tommy2002t/LITHIUM_BOARD/LITHIUM_Board_Design_Calculations.xlsx

Sheet: Summary
LITHIUM Board Design Calculations
IC | Design item | Selected schematic values | Result | Meaning
BQ25750 | FB divider / battery regulation | RTOP=249 kΩ, RBOT=34.8 kΩ, VFB=1.536 V, RFBG=33 Ω | VBAT ≈ 12.54 V | Battery regulation voltage for the 3S pack.
BQ25750 | ACUV / ACOV divider | RAC1=1 MΩ, RAC2=100 kΩ, RAC3=20 kΩ | ACUV≈10.27 V, ACOV≈67.20 V | Input valid/overvoltage thresholds.
BQ25750 | Hardware charge current limit | RICHG=34.8 kΩ, KICHG=50 A·kΩ | ICHG≈1.44 A | Maximum charge current set by the ICHG pin.
BQ25750 | Hardware input current limit | RILIM=10 kΩ, KILIM=50 A·kΩ | ILIM≈5.00 A | Maximum input current set by ILIM_HIZ.
BQ76942 | Internal balancing current | RIN=100 Ω, RCB=25 Ω typ, VCELL=4.2 V | IBAL≈18.7 mA | Approximate internal cell balancing current.
BQ25750 Calculations
Variable / Step | Symbol | Value | Unit | Excel formula
1. FB bottom resistor / battery regulation voltage
Top FB resistor | RTOP | 249000.0000 | Ω
Feedback reference voltage | VFB | 1.5360 | V
Target battery regulation voltage | VBATREG_target | 12.6000 | V
FBG internal/reference resistance | RFBG | 33.0000 | Ω
Datasheet formula |  |  |  | RBOT = RTOP × VFB / (VBATREG − VFB) + RFBG
Ideal RBOT calculation | RBOT_ideal | 34601.33 | Ω | 249000 × 1,536 / (12,6 − 1,536) + 33
Selected RBOT | RBOT_selected | 34800.0000 | Ω
Actual VBAT formula |  |  |  | VBAT = VFB × (1 + RTOP / (RBOT_selected − RFBG))
Actual battery regulation voltage | VBAT_actual | 12.5368 | V | 1,536 × (1 + 249000 / (34800 − 33))
Meaning |  |  |  |  | The battery pack will regulate near 12.54 V
2. ACUV / ACOV divider thresholds
RAC1 | RAC1 | 1000.0000 | kΩ
RAC2 | RAC2 | 100.0000 | kΩ
RAC3 | RAC3 | 20.0000 | kΩ | 10 kΩ + 10 kΩ
ACUV reference | VACUV_REF | 1.1000 | V
ACOV reference | VACOV_REF | 1.2000 | V
Sum of divider resistors | RSUM | 1120.0000 | kΩ | RAC1 + RAC2 + RAC3
Lower divider sum | RLOW | 120.0000 | kΩ | RAC2 + RAC3
Datasheet ACUV formula |  |  |  | VACUV = 1.1 × (RAC1 + RAC2 + RAC3) / (RAC2 + RAC3)
ACUV threshold | VACUV | 10.27 | V | 1,1 × 1120 / 120
Datasheet ACOV formula |  |  |  | VACOV = 1.2 × (RAC1 + RAC2 + RAC3) / RAC3
ACOV threshold | VACOV | 67.20 | V | 1,2 × 1120 / 20
Meaning |  |  |  |  | Upper Voltage: 67.2V Lower Voltage: 10.27V
3. ICHG resistor / hardware charge current limit
KICHG typical | KICHG | 50.0000 | A·kΩ
Selected ICHG resistor | RICHG | 34.8000 | kΩ
Datasheet formula |  |  |  | ICHG_MAX = KICHG / RICHG
Charge current limit | ICHG_MAX | 1.4368 | A | 50 / 34,8
Meaning |  |  |  |  | The charger hardware limit is about 1.44 A.
4. ILIM_HIZ resistor / hardware input current limit
KILIM typical | KILIM | 50.0000 | A·kΩ
Selected ILIM_HIZ resistor | RILIM | 10.0000 | kΩ
RAC_SNS | RAC_SNS | 2.0000 | mΩ
Datasheet formula |  |  |  | ILIM = KILIM / RILIM
Input current limit | ILIM | 5.00 | A | 50 / 10
Meaning |  |  |  |  | The hardware input limit is about 5 A.
BQ76942 Calculations
Variable / Step | Symbol | Value | Unit | Excel formula
2. Internal cell balancing current
Cell input resistor | RIN | 100.0000 | Ω
Internal balancing resistance typical | RCB | 25.0000 | Ω
Maximum cell voltage | VCELL_MAX | 4.2000 | V
Nominal cell voltage | VCELL_NOM | 3.7000 | V
Formula |  |  |  | IBAL = VCELL / (2 × RIN + RCB)
Balancing current at 4.2 V | IBAL_MAX |  | A
Balancing current at 3.7 V | IBAL_NOM |  | A
Meaning |  | 0.01867 |  | 4,2 / (2 × 100 + 25) | Internal Balancing: 16–19 mA
 |  | 0.01644 |  | 3,7 / (2 × 100 + 25)

Sheet: BQ25750_Calcs
BQ25750 Calculations
Variable / Step | Symbol | Value | Unit | Excel formula / manual calculation
1. FB bottom resistor / battery regulation voltage
Top FB resistor | RTOP | 249000.0000 | Ω
Feedback reference voltage | VFB | 1.5360 | V
Target battery regulation voltage | VBATREG_target | 12.6000 | V
FBG internal/reference resistance | RFBG | 33.0000 | Ω
Datasheet formula |  |  |  | RBOT = RTOP × VFB / (VBATREG − VFB) + RFBG
Ideal RBOT calculation | RBOT_ideal | 34601.33 | Ω | 249000 × 1,536 / (12,6 − 1,536) + 33
Selected RBOT | RBOT_selected | 34800.0000 | Ω
Actual VBAT formula |  |  |  | VBAT = VFB × (1 + RTOP / (RBOT_selected − RFBG))
Actual battery regulation voltage | VBAT_actual | 12.5368 | V | 1,536 × (1 + 249000 / (34800 − 33))
Meaning |  |  |  |  | The battery pack will regulate near 12.54 V, slightly below 12.60 V.
2. ACUV / ACOV divider thresholds
RAC1 | RAC1 | 1000.0000 | kΩ
RAC2 | RAC2 | 100.0000 | kΩ
RAC3 | RAC3 | 20.0000 | kΩ | 10 kΩ + 10 kΩ
ACUV reference | VACUV_REF | 1.1000 | V
ACOV reference | VACOV_REF | 1.2000 | V
Sum of divider resistors | RSUM | 1120.0000 | kΩ | RAC1 + RAC2 + RAC3
Lower divider sum | RLOW | 120.0000 | kΩ | RAC2 + RAC3
Datasheet ACUV formula |  |  |  | VACUV = 1.1 × (RAC1 + RAC2 + RAC3) / (RAC2 + RAC3)
ACUV threshold | VACUV | 10.27 | V | 1,1 × 1120 / 120
Datasheet ACOV formula |  |  |  | VACOV = 1.2 × (RAC1 + RAC2 + RAC3) / RAC3
ACOV threshold | VACOV | 67.20 | V | 1,2 × 1120 / 20
Meaning |  |  |  |  | Upper Voltage: 67.2V Lower Voltage: 10.27V
3. ICHG resistor / hardware charge current limit
KICHG typical | KICHG | 50.0000 | A·kΩ
Selected ICHG resistor | RICHG | 34.8000 | kΩ
Datasheet formula |  |  |  | ICHG_MAX = KICHG / RICHG
Charge current limit | ICHG_MAX | 1.4368 | A | 50 / 34,8
Meaning |  |  |  |  | The charger hardware limit is about 1.44 A.
4. ILIM_HIZ resistor / hardware input current limit
KILIM typical | KILIM | 50.0000 | A·kΩ
Selected ILIM_HIZ resistor | RILIM | 10.0000 | kΩ
RAC_SNS | RAC_SNS | 2.0000 | mΩ
Datasheet formula |  |  |  | ILIM = KILIM / RILIM
Input current limit | ILIM | 5.00 | A | 50 / 10
Meaning |  |  |  |  | The hardware input limit is about 5 A.

Sheet: BQ76942_Calcs
BQ76942 Calculations
Variable / Step | Symbol | Value | Unit | Excel formula / manual calculation
2. Internal cell balancing current
Cell input resistor | RIN | 100.0000 | Ω
Internal balancing resistance typical | RCB | 25.0000 | Ω
Maximum cell voltage | VCELL_MAX | 4.2000 | V
Nominal cell voltage | VCELL_NOM | 3.7000 | V
Formula |  |  |  | IBAL = VCELL / (2 × RIN + RCB)
Balancing current at 4.2 V | IBAL_MAX |  | A
Balancing current at 3.7 V | IBAL_NOM |  | A
Meaning |  | 0.01867 |  | 4,2 / (2 × 100 + 25) | Internal Balancing: 16–19 mA
 |  | 0.01644 |  | 3,7 / (2 × 100 + 25)
