tommy2002t/LITHIUM_BOARD/Lithium_Board.step

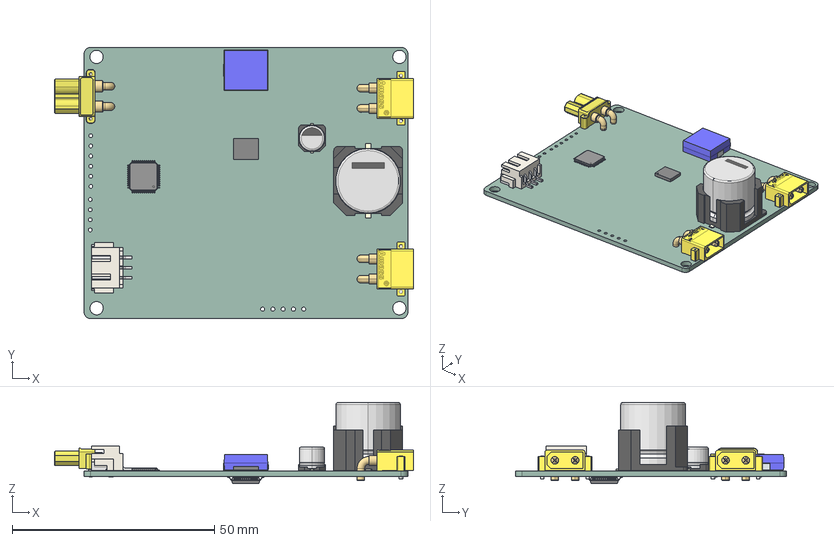
[picture p1: CAD file, 2026-06-28]
Lithium_Board.step
88.7 x 67.0 x 20.0 mm
WSIZE CODE D-001
WSIZE CODE D-002
WSIZE CODE D-003 x 2
BODY_VBC48A
LEAD_VBC48A x 48
FilletPin1
FilletPin2
XT30PW-F
XT30PW-M x 2
BQ25750RRVR
S3B-XH-SM4-TB_LF__SN_
SIZE CODE J16-001
SIZE CODE J16-002
SIZE CODE J16-003 x 2
SIZE CODE J16-004 x 2
PinsArrayLR
PinsArrayTB
Lithium_Board_PCB
