tommy2002t/LITHIUM_BOARD/Lithium_Footprints/LIB_1N4148WQ-7-F/1N4148WQ-7-F/3D/1N4148WQ-7-F.stp

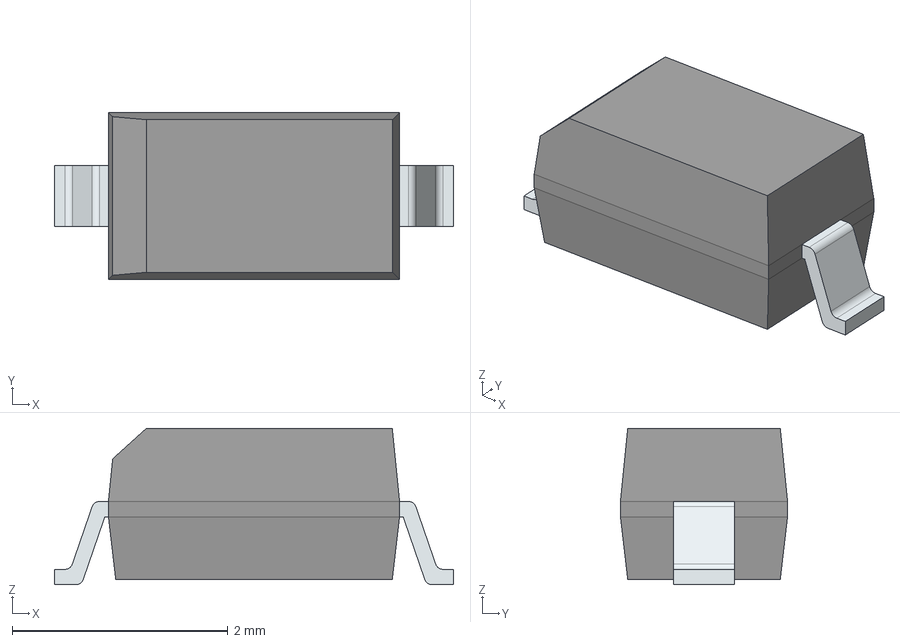
[picture p2: CAD file, 2026-05-30]
Lithium_Footprints/LIB_1N4148WQ-7-F/1N4148WQ-7-F/3D/1N4148WQ-7-F.stp
3.70 x 1.55 x 1.45 mm
FilletPinL
FilletPinR
