tommy2002t/LITHIUM_BOARD/Lithium_Footprints/LIB_ACT45B-101-2P-TL003/ACT45B-101-2P-TL003/3D/ACT45B-101-2P-TL003.stp

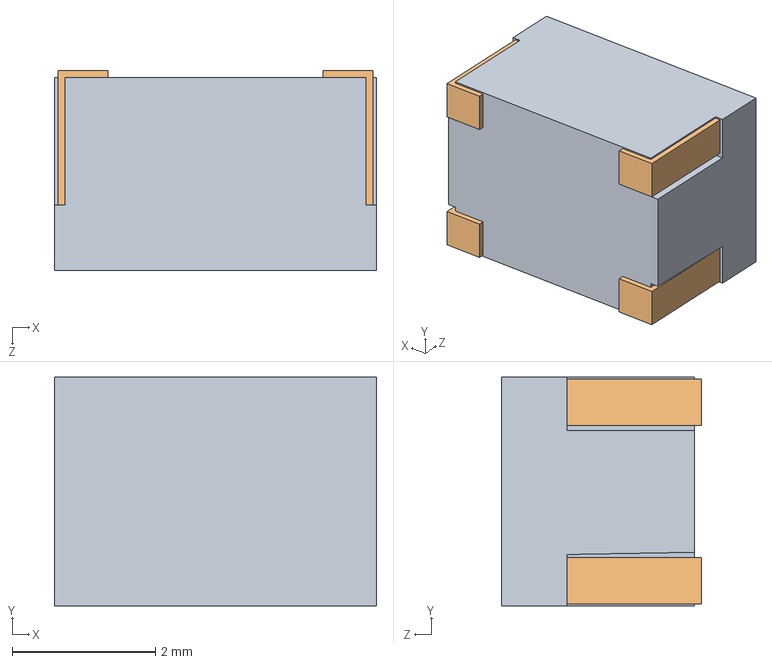
[picture p3: CAD file, 2026-06-06]
Lithium_Footprints/LIB_ACT45B-101-2P-TL003/ACT45B-101-2P-TL003/3D/ACT45B-101-2P-TL003.stp
4.50 x 3.20 x 2.80 mm
ACT45B DRコアブロック(typ size)
ACT45B 端子ブロック(typ size) x 4
