tommy2002t/LITHIUM_BOARD/Lithium_Footprints/LIB_C0603C101J5GACTU/C0603C101J5GACTU/3D/C0603C101J5GACTU.stp

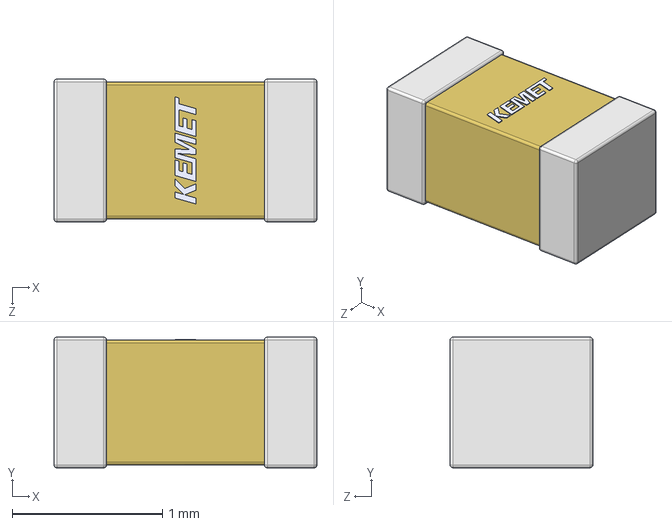
[picture p4: CAD file, 2026-05-30]
Lithium_Footprints/LIB_C0603C101J5GACTU/C0603C101J5GACTU/3D/C0603C101J5GACTU.stp
1.75 x 0.87 x 0.95 mm
