tommy2002t/LITHIUM_BOARD/Lithium_Footprints/LIB_C0603C104K1RACAUTO/C0603C104K1RACAUTO/3D/C0603C104K1RACAUTO.stp

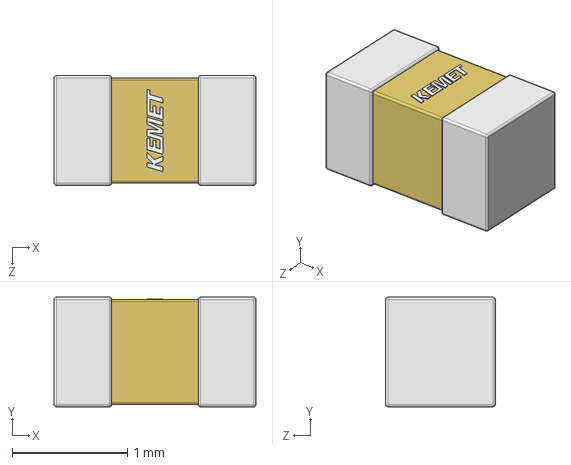
[picture p5: CAD file, 2026-05-30]
Lithium_Footprints/LIB_C0603C104K1RACAUTO/C0603C104K1RACAUTO/3D/C0603C104K1RACAUTO.stp
1.75 x 0.95 x 0.95 mm
