tommy2002t/LITHIUM_BOARD/Lithium_Footprints/LIB_C0603C122K5RACTU/C0603C122K5RACTU/3D/C0603C122K5RACTU.stp

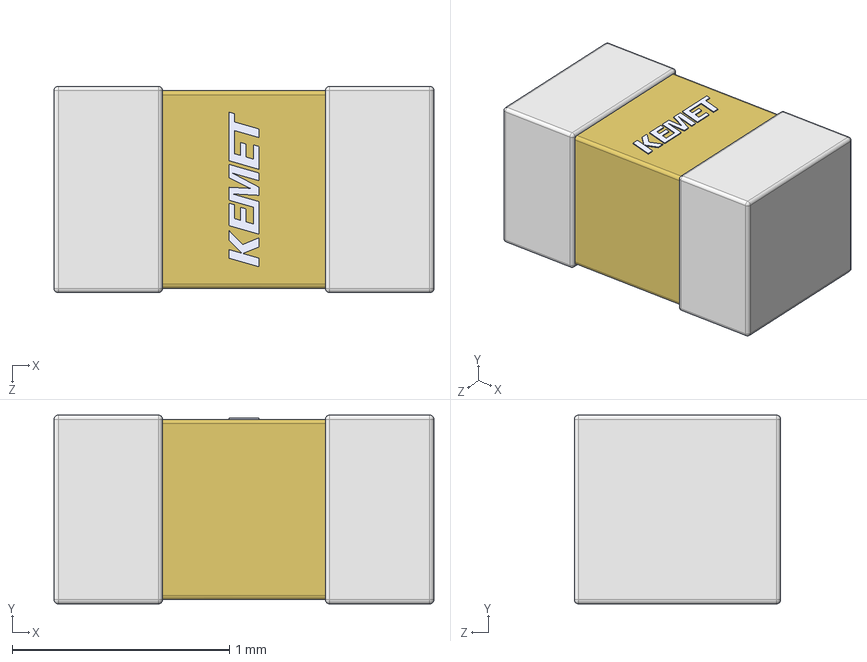
[picture p6: CAD file, 2026-05-30]
Lithium_Footprints/LIB_C0603C122K5RACTU/C0603C122K5RACTU/3D/C0603C122K5RACTU.stp
1.75 x 0.87 x 0.95 mm
