tommy2002t/LITHIUM_BOARD/Lithium_Footprints/LIB_C0805C224K5RACTU/C0805C224K5RACTU/3D/C0805C224K5RACTU.stp

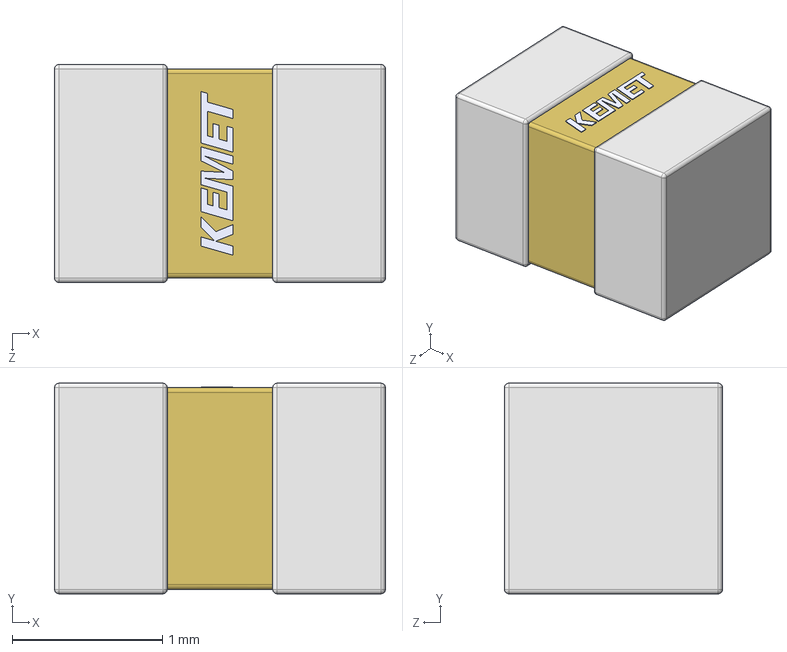
[picture p7: CAD file, 2026-05-30]
Lithium_Footprints/LIB_C0805C224K5RACTU/C0805C224K5RACTU/3D/C0805C224K5RACTU.stp
2.20 x 1.40 x 1.45 mm
