tommy2002t/LITHIUM_BOARD/Lithium_Footprints/LIB_C0805X474K5RECAUTO/C0805X474K5RECAUTO/3D/C0805X474K5RECAUTO.stp

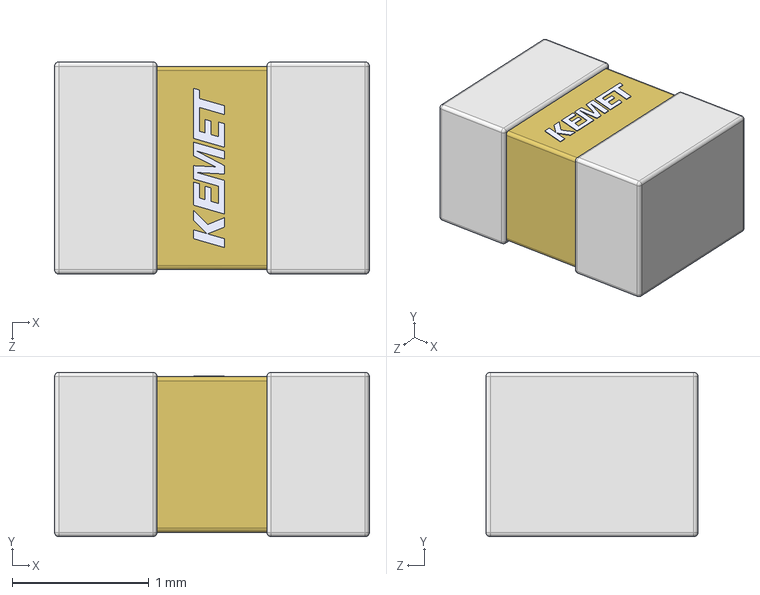
[picture p8: CAD file, 2026-05-30]
Lithium_Footprints/LIB_C0805X474K5RECAUTO/C0805X474K5RECAUTO/3D/C0805X474K5RECAUTO.stp
2.30 x 1.20 x 1.55 mm
