tommy2002t/LITHIUM_BOARD/Lithium_Footprints/LIB_C1206C225K5RACTU/C1206C225K5RACTU/3D/C1206C225K5RACTU.stp

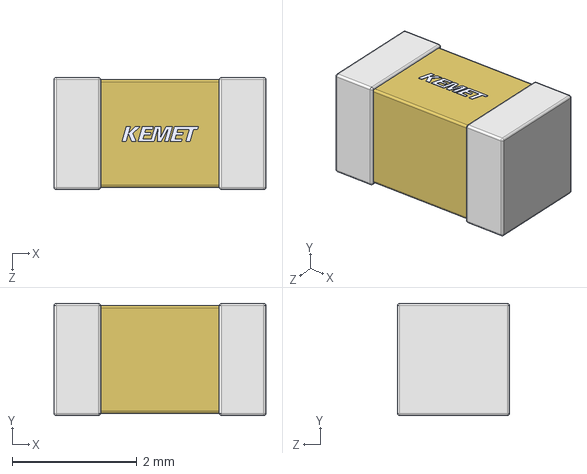
[picture p9: CAD file, 2026-05-30]
Lithium_Footprints/LIB_C1206C225K5RACTU/C1206C225K5RACTU/3D/C1206C225K5RACTU.stp
3.40 x 1.80 x 1.80 mm
