tommy2002t/LITHIUM_BOARD/Lithium_Footprints/LIB_C1210C154K5RACTU/C1210C154K5RACTU/3D/C1210C154K5RACTU.stp

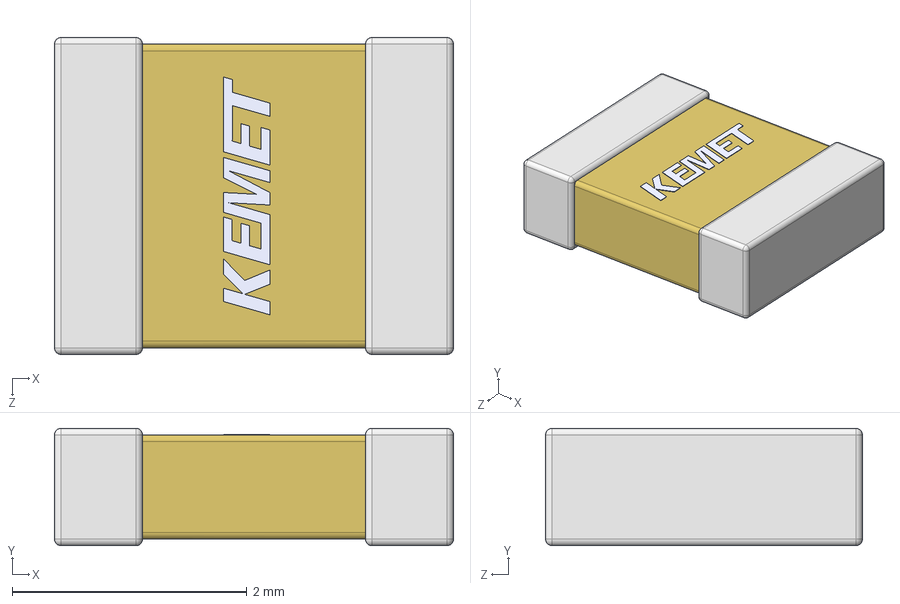
[picture p10: CAD file, 2026-05-30]
Lithium_Footprints/LIB_C1210C154K5RACTU/C1210C154K5RACTU/3D/C1210C154K5RACTU.stp
3.40 x 1.00 x 2.70 mm
