tommy2002t/LITHIUM_BOARD/Lithium_Footprints/LIB_C2012X7R1H105K125AB/C2012X7R1H105K125AB/3D/C2012X7R1H105K125AB.stp

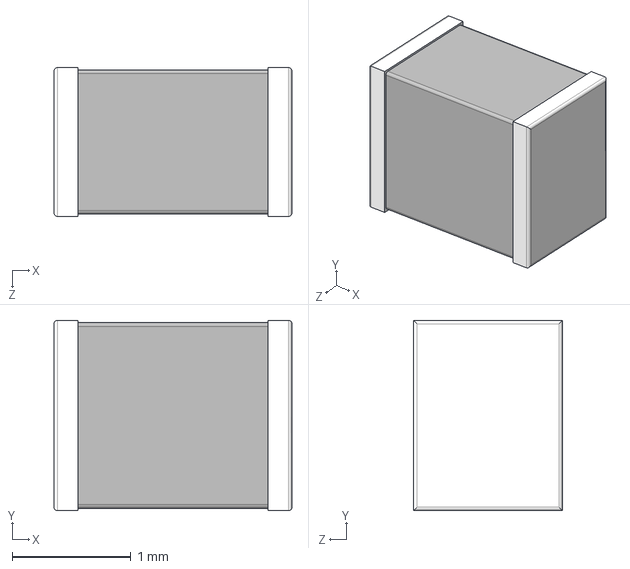
[picture p11: CAD file, 2026-05-30]
Lithium_Footprints/LIB_C2012X7R1H105K125AB/C2012X7R1H105K125AB/3D/C2012X7R1H105K125AB.stp
2.00 x 1.60 x 1.25 mm
