tommy2002t/LITHIUM_BOARD/Lithium_Footprints/LIB_CC0603KRX7R9BB104/CC0603KRX7R9BB104/3D/CC0603KRX7R9BB104.stp

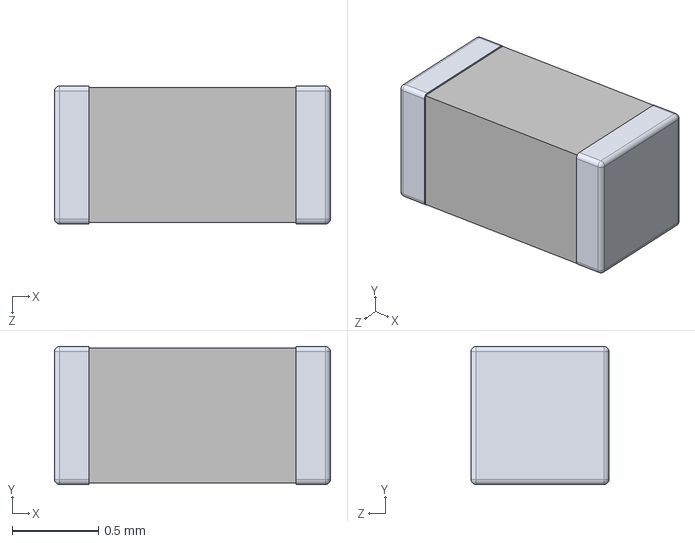
[picture p12: CAD file, 2026-05-30]
Lithium_Footprints/LIB_CC0603KRX7R9BB104/CC0603KRX7R9BB104/3D/CC0603KRX7R9BB104.stp
1.60 x 0.8 x 0.8 mm
