tommy2002t/LITHIUM_BOARD/Lithium_Footprints/LIB_CDBMT2100-HF/CDBMT2100-HF/3D/CDBMT2100-HF.stp

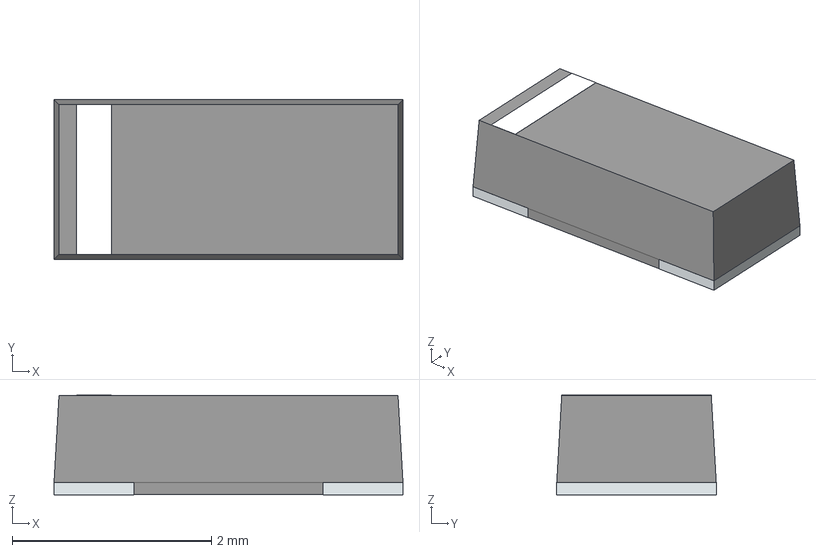
[picture p13: CAD file, 2026-06-14]
Lithium_Footprints/LIB_CDBMT2100-HF/CDBMT2100-HF/3D/CDBMT2100-HF.stp
3.50 x 1.60 x 1.00 mm
PinKIdent
PinK
PinA
