tommy2002t/LITHIUM_BOARD/Lithium_Footprints/LIB_CDSOT23-T24CAN/CDSOT23-T24CAN/3D/CDSOT23-T24CAN.stp

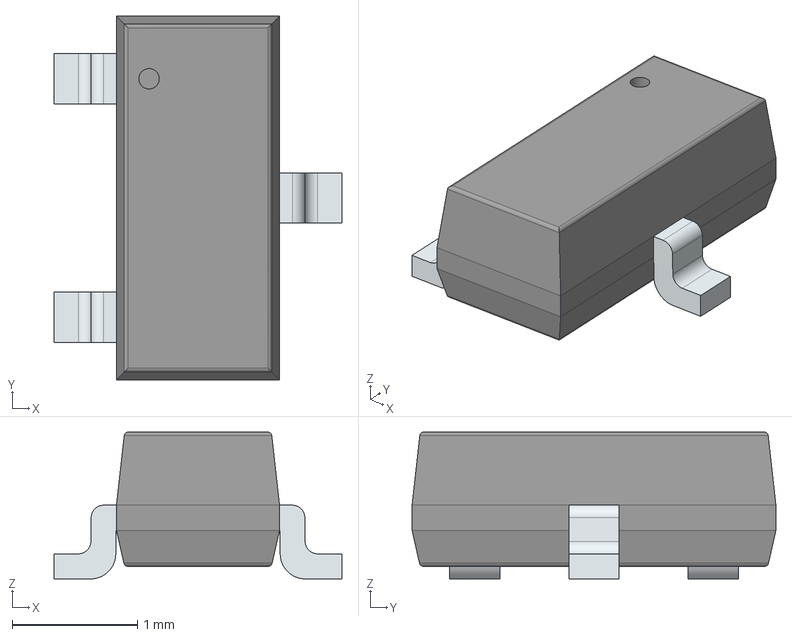
[picture p14: CAD file, 2026-06-06]
Lithium_Footprints/LIB_CDSOT23-T24CAN/CDSOT23-T24CAN/3D/CDSOT23-T24CAN.stp
2.29 x 2.90 x 1.17 mm
PinsArrayL
FilletPinR
