tommy2002t/LITHIUM_BOARD/Lithium_Footprints/LIB_CGA5L2X7R2A474K160AA/CGA5L2X7R2A474K160AA/3D/CGA5L2X7R2A474K160AA.stp

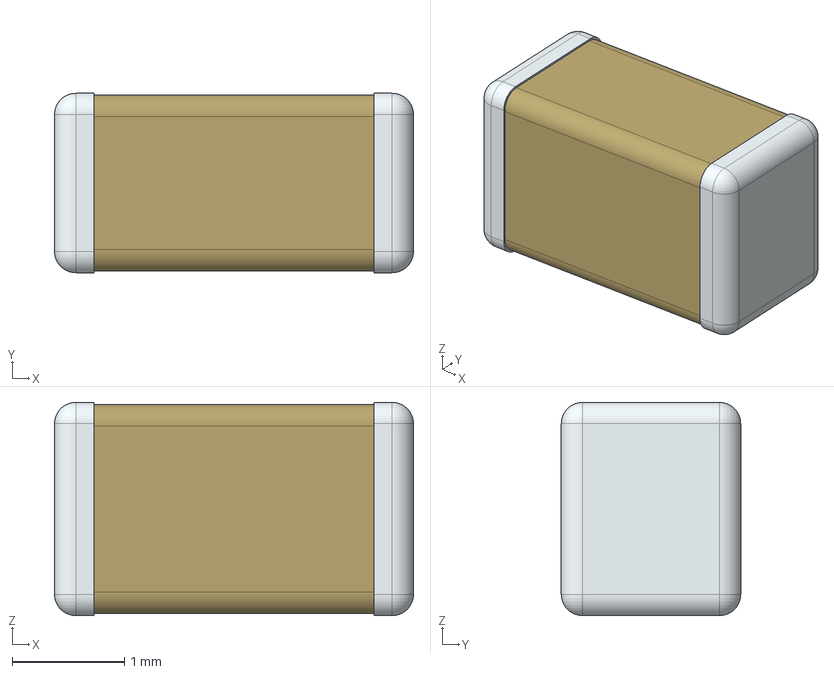
[picture p15: CAD file, 2026-05-30]
Lithium_Footprints/LIB_CGA5L2X7R2A474K160AA/CGA5L2X7R2A474K160AA/3D/CGA5L2X7R2A474K160AA.stp
3.20 x 1.60 x 1.90 mm
