tommy2002t/LITHIUM_BOARD/Lithium_Footprints/LIB_CL31B225KCHSNNE/CL31B225KCHSNNE/3D/CL31B225KCHSNNE.stp

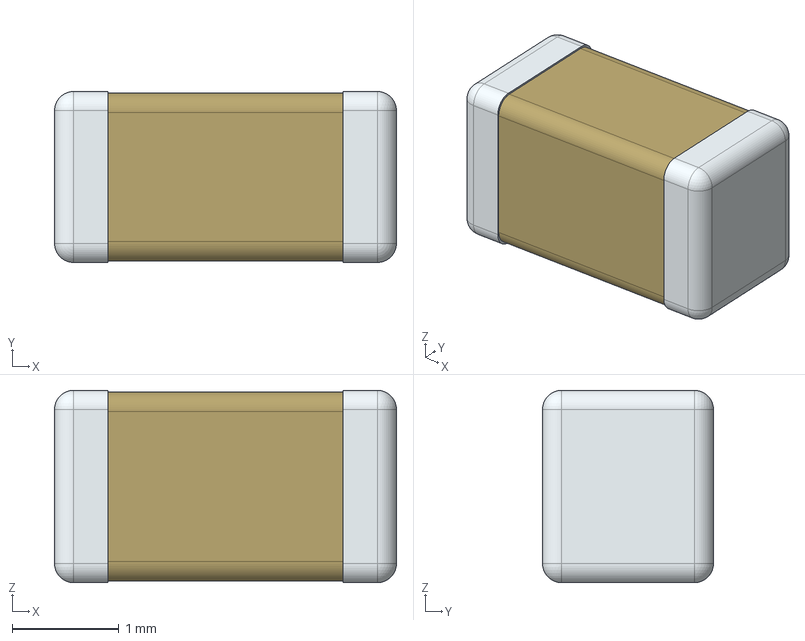
[picture p16: CAD file, 2026-05-30]
Lithium_Footprints/LIB_CL31B225KCHSNNE/CL31B225KCHSNNE/3D/CL31B225KCHSNNE.stp
3.20 x 1.60 x 1.80 mm
