tommy2002t/LITHIUM_BOARD/Lithium_Footprints/LIB_CL32B106KBVVPLE/CL32B106KBVVPLE/3D/CL32B106KBVVPLE.stp

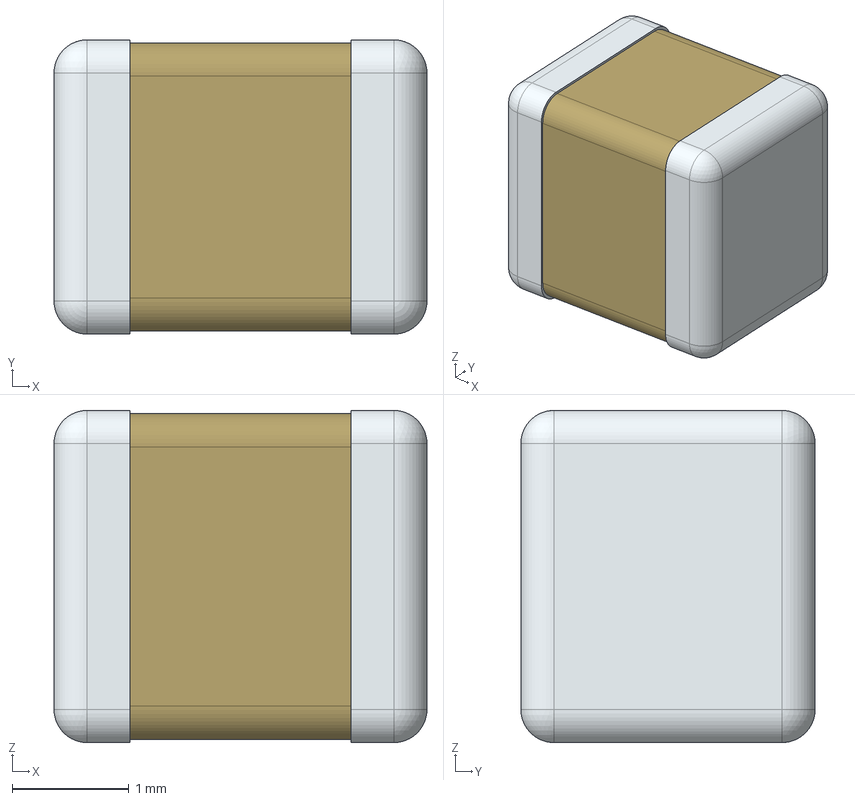
[picture p17: CAD file, 2026-05-30]
Lithium_Footprints/LIB_CL32B106KBVVPLE/CL32B106KBVVPLE/3D/CL32B106KBVVPLE.stp
3.20 x 2.52 x 2.85 mm
