tommy2002t/LITHIUM_BOARD/Lithium_Footprints/LIB_EEE-TP1K391V/EEE-TP1K391V/3D/EEE-TP1K391V.stp

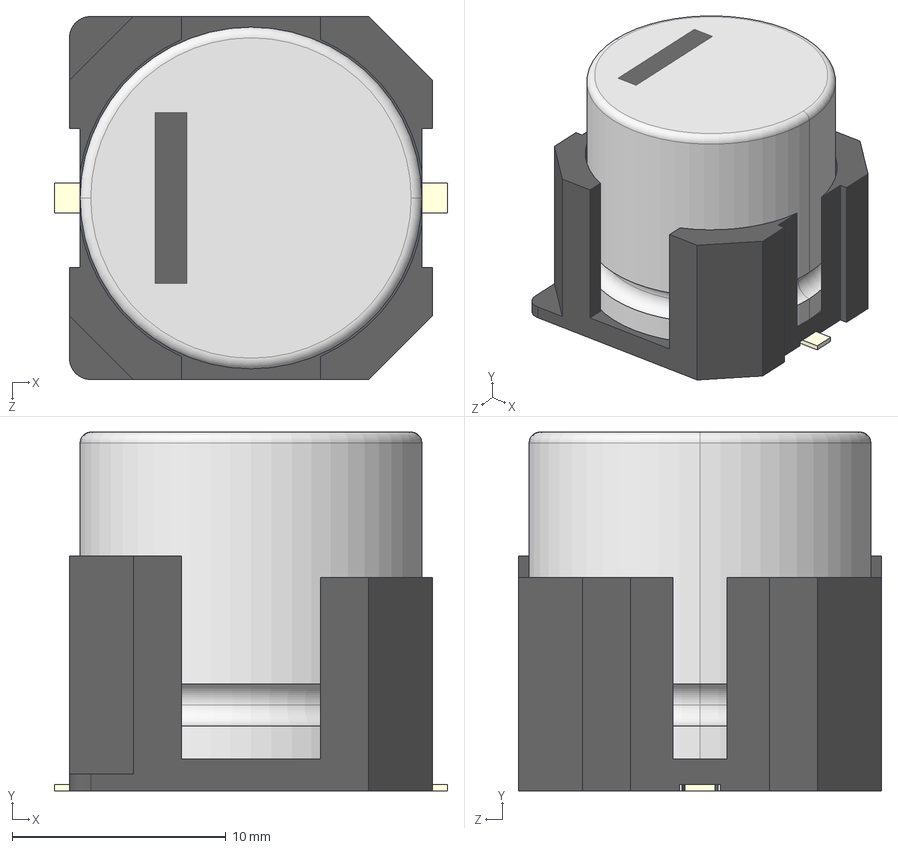
[picture p18: CAD file, 2026-05-30]
Lithium_Footprints/LIB_EEE-TP1K391V/EEE-TP1K391V/3D/EEE-TP1K391V.stp
18.4 x 16.8 x 17.0 mm
SIZE CODE J16-001
SIZE CODE J16-002
SIZE CODE J16-003 x 2
SIZE CODE J16-004 x 2
