tommy2002t/LITHIUM_BOARD/Lithium_Footprints/LIB_EEH-ZL1E151P/EEH-ZL1E151P/3D/EEH-ZL1E151P.stp

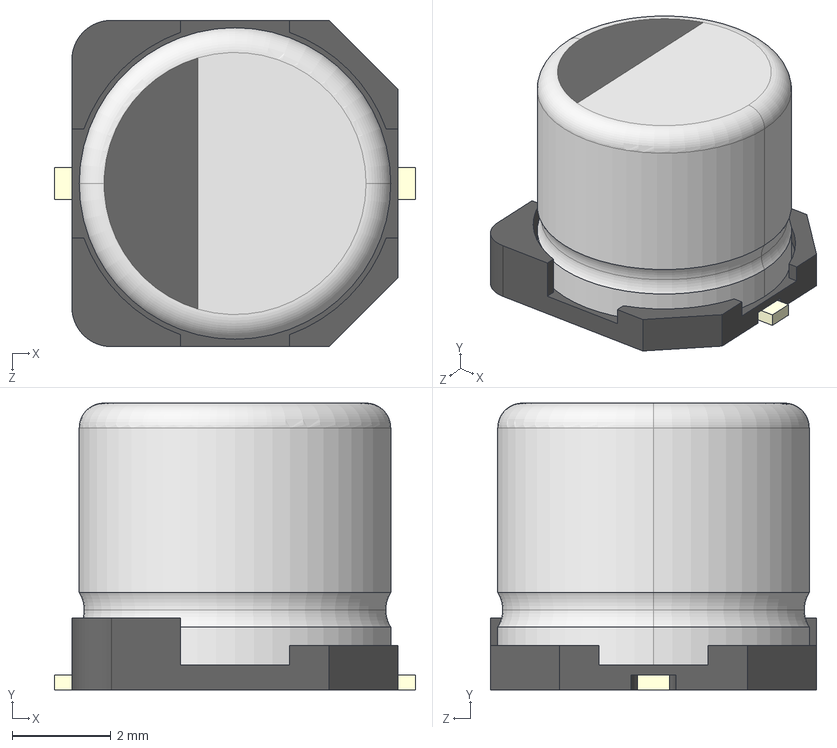
[picture p19: CAD file, 2026-05-30]
Lithium_Footprints/LIB_EEH-ZL1E151P/EEH-ZL1E151P/3D/EEH-ZL1E151P.stp
7.30 x 5.80 x 6.60 mm
標準SIZE CODE D-001
標準SIZE CODE D-002
標準SIZE CODE D-003 x 2
