tommy2002t/LITHIUM_BOARD/Lithium_Footprints/LIB_ERJ-2RKF60R4X/ERJ-2RKF60R4X/3D/ERJ-2RKF60R4X.stp

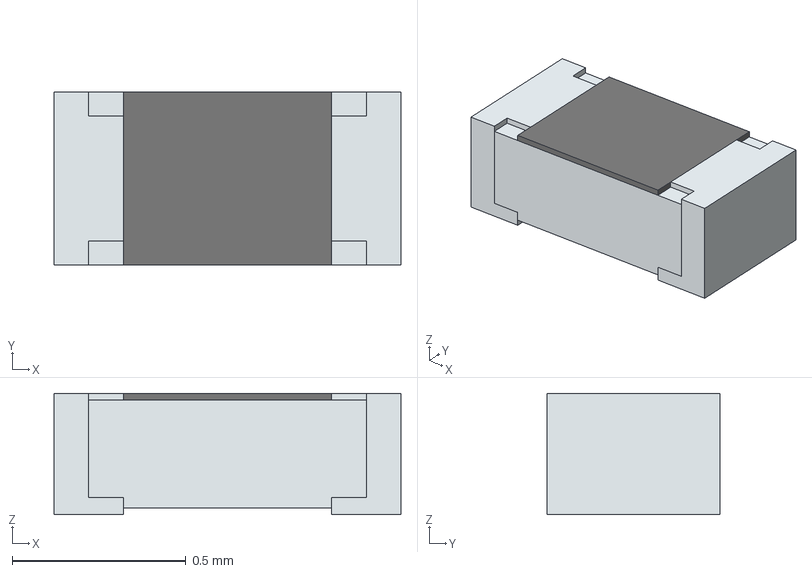
[picture p20: CAD file, 2026-06-06]
Lithium_Footprints/LIB_ERJ-2RKF60R4X/ERJ-2RKF60R4X/3D/ERJ-2RKF60R4X.stp
1.00 x 0.5 x 0.35 mm
solidBody
Terminal
solidTop
