tommy2002t/LITHIUM_BOARD/Lithium_Footprints/LIB_ERJ-3GEY0R00V/ERJ-3GEY0R00V/3D/ERJ-3GEY0R00V.stp

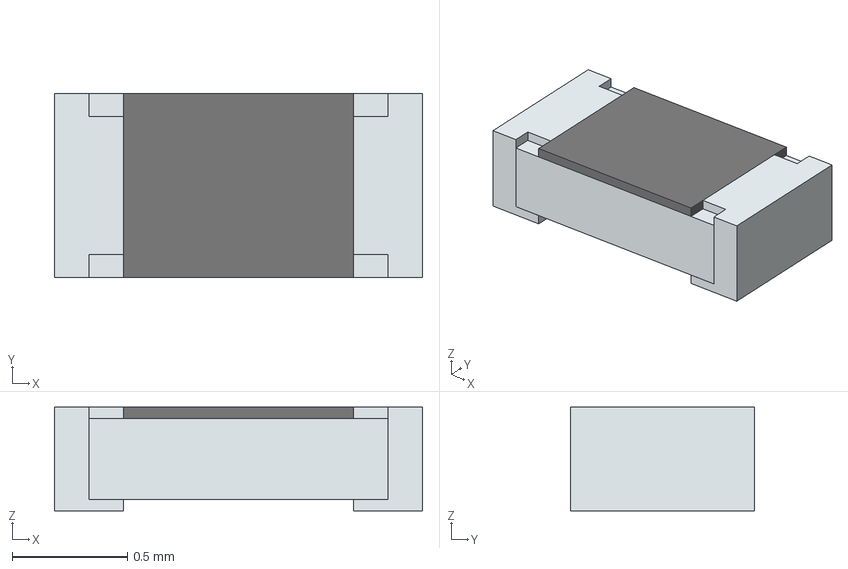
[picture p21: CAD file, 2026-05-30]
Lithium_Footprints/LIB_ERJ-3GEY0R00V/ERJ-3GEY0R00V/3D/ERJ-3GEY0R00V.stp
1.60 x 0.8 x 0.45 mm
solidBody
Terminal
solidTop
