tommy2002t/LITHIUM_BOARD/Lithium_Footprints/LIB_ESDCAN24-2BLY/ESDCAN24-2BLY/3D/ESDCAN24-2BLY.stp

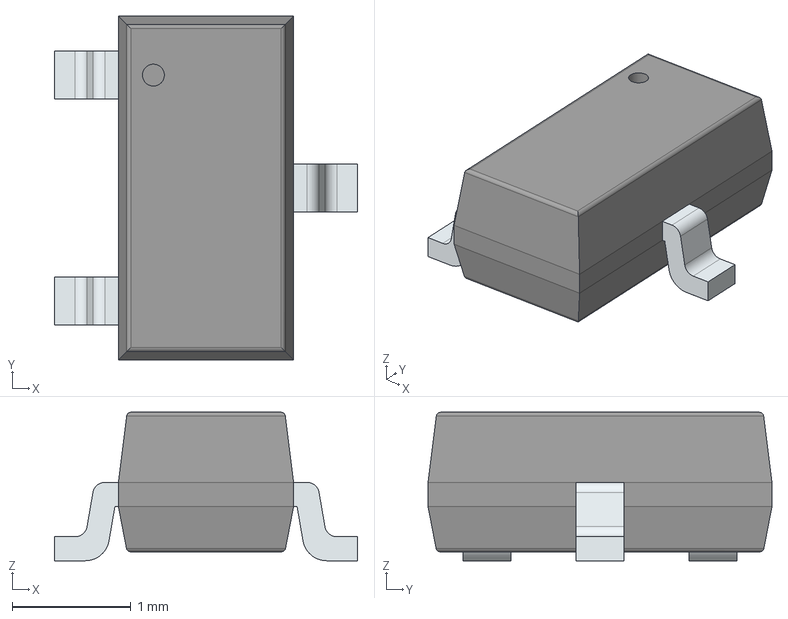
[picture p22: CAD file, 2026-07-23]
Lithium_Footprints/LIB_ESDCAN24-2BLY/ESDCAN24-2BLY/3D/ESDCAN24-2BLY.stp
2.55 x 2.90 x 1.25 mm
PinsArrayL
FilletPinR
