tommy2002t/LITHIUM_BOARD/Lithium_Footprints/LIB_GCM188R71H103KA37J/GCM188R71H103KA37J/3D/GCM188R71H103KA37J.stp

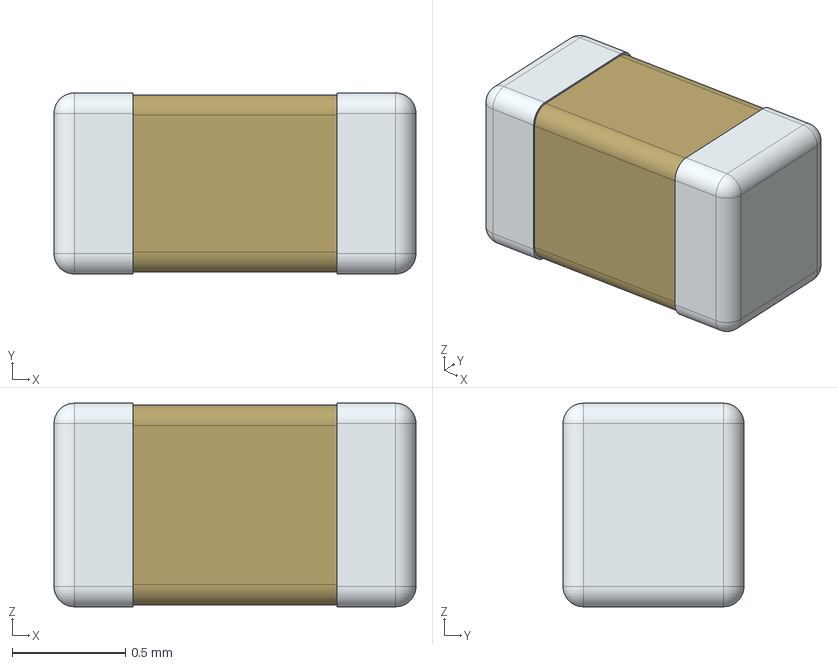
[picture p23: CAD file, 2026-05-30]
Lithium_Footprints/LIB_GCM188R71H103KA37J/GCM188R71H103KA37J/3D/GCM188R71H103KA37J.stp
1.60 x 0.8 x 0.9 mm
