tommy2002t/LITHIUM_BOARD/Lithium_Footprints/LIB_GRM155R71H104KE14J/GRM155R71H104KE14J/3D/GRM155R71H104KE14J.stp

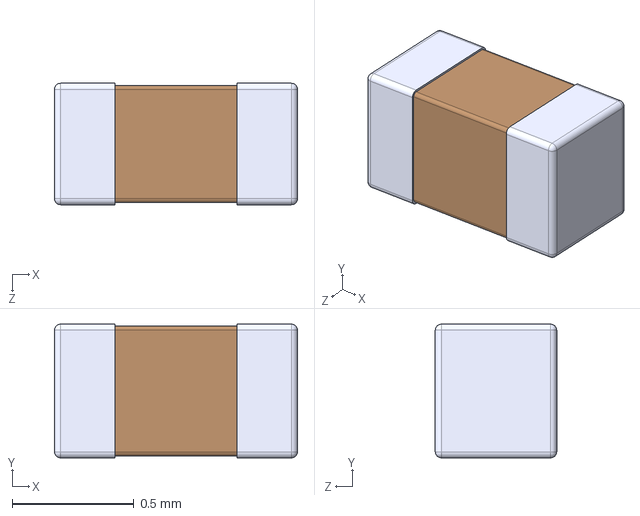
[picture p24: CAD file, 2026-06-06]
Lithium_Footprints/LIB_GRM155R71H104KE14J/GRM155R71H104KE14J/3D/GRM155R71H104KE14J.stp
1.00 x 0.55 x 0.5 mm
