tommy2002t/LITHIUM_BOARD/Lithium_Footprints/LIB_GRM188R72A472KA01D/GRM188R72A472KA01D/3D/GRM188R72A472KA01D.stp

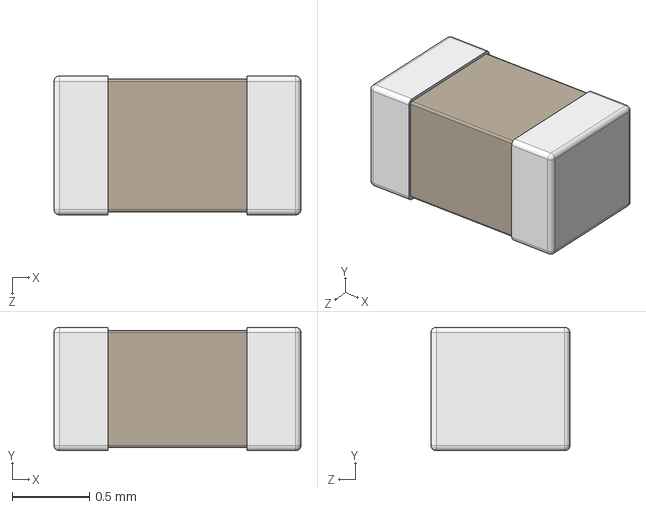
[picture p25: CAD file, 2026-06-06]
Lithium_Footprints/LIB_GRM188R72A472KA01D/GRM188R72A472KA01D/3D/GRM188R72A472KA01D.stp
1.60 x 0.8 x 0.9 mm
