tommy2002t/LITHIUM_BOARD/Lithium_Footprints/LIB_KAM32LR72A475KU/KAM32LR72A475KU/3D/KAM32LR72A475KU.stp

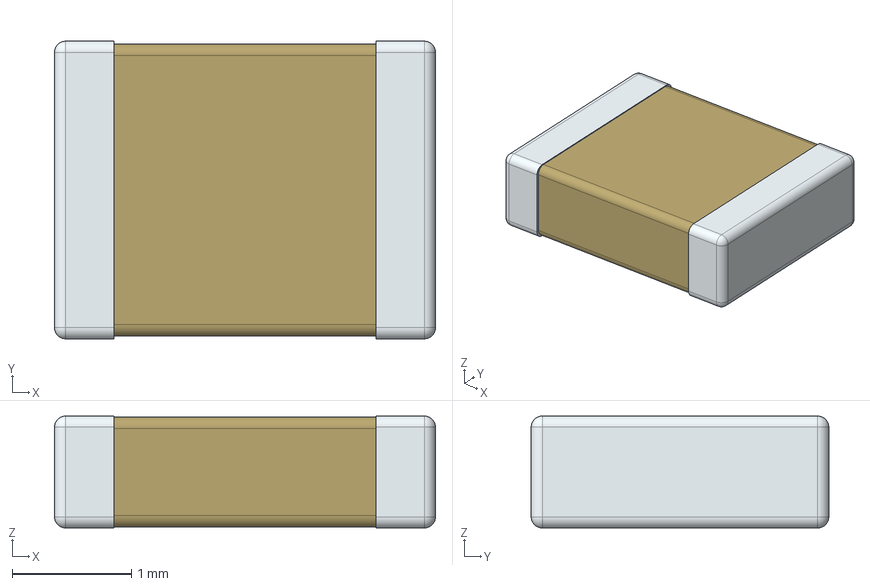
[picture p26: CAD file, 2026-05-30]
Lithium_Footprints/LIB_KAM32LR72A475KU/KAM32LR72A475KU/3D/KAM32LR72A475KU.stp
3.20 x 2.50 x 0.94 mm
