tommy2002t/LITHIUM_BOARD/Lithium_Footprints/LIB_LTST-C190KGKT/LTST-C190KGKT/3D/LTST-C190KGKT.stp

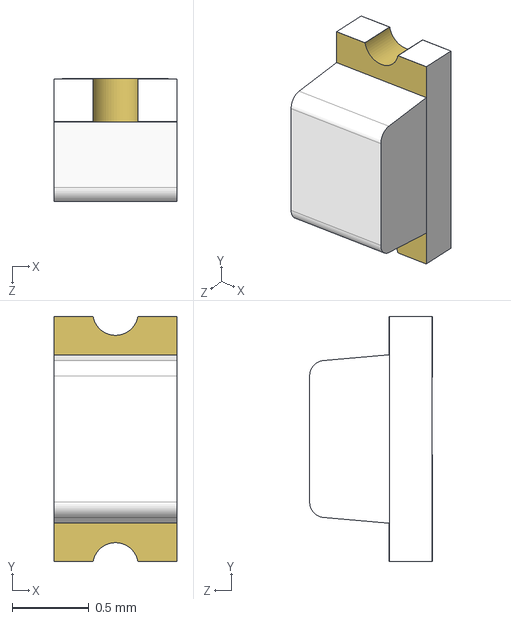
[picture p27: CAD file, 2026-06-06]
Lithium_Footprints/LIB_LTST-C190KGKT/LTST-C190KGKT/3D/LTST-C190KGKT.stp
0.8 x 1.60 x 0.801 mm
