tommy2002t/LITHIUM_BOARD/Lithium_Footprints/LIB_MCP1792T-3302H_DB/MCP1792T-3302H_DB/3D/MCP1792T-3302H_DB.stp

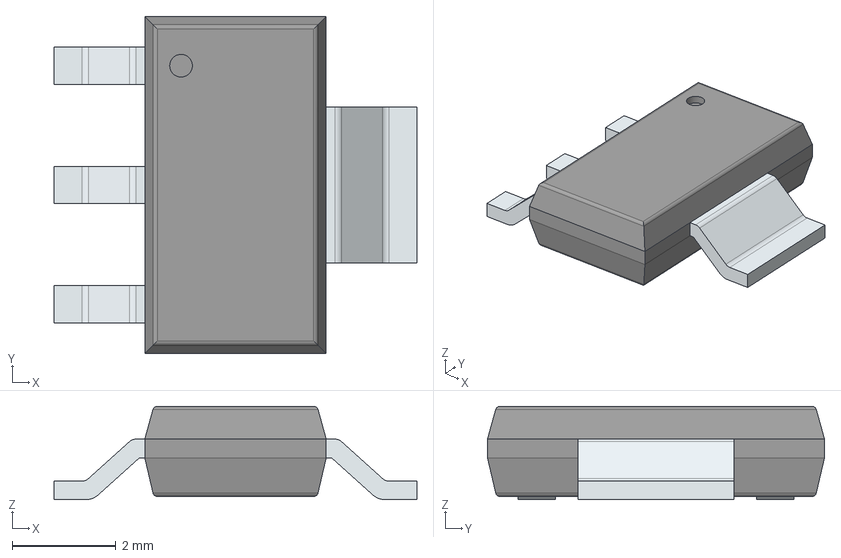
[picture p28: CAD file, 2026-07-16]
Lithium_Footprints/LIB_MCP1792T-3302H_DB/MCP1792T-3302H_DB/3D/MCP1792T-3302H_DB.stp
7.00 x 6.50 x 1.80 mm
PinsArrayL
FilletPinR
