tommy2002t/LITHIUM_BOARD/Lithium_Footprints/LIB_MMBT5551LT1G/MMBT5551LT1G/3D/MMBT5551LT1G.stp

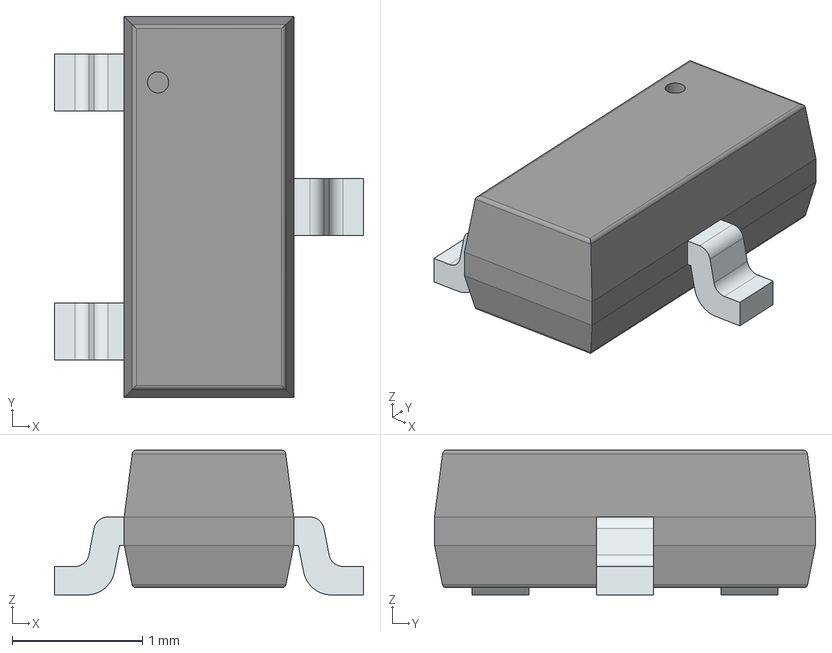
[picture p29: CAD file, 2026-05-30]
Lithium_Footprints/LIB_MMBT5551LT1G/MMBT5551LT1G/3D/MMBT5551LT1G.stp
2.37 x 2.92 x 1.11 mm
PinsArrayL
FilletPinR
