tommy2002t/LITHIUM_BOARD/Lithium_Footprints/LIB_PMR100HZPFU5L00/PMR100HZPFU5L00/3D/PMR100HZPFU5L00.stp

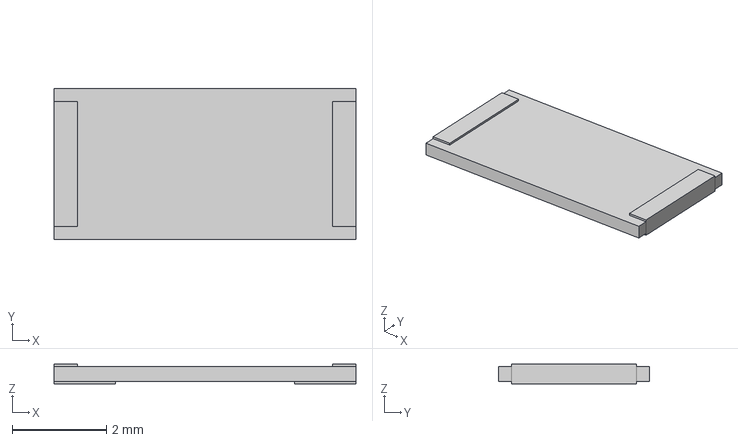
[picture p30: CAD file, 2026-05-30]
Lithium_Footprints/LIB_PMR100HZPFU5L00/PMR100HZPFU5L00/3D/PMR100HZPFU5L00.stp
6.40 x 3.20 x 0.42 mm
