tommy2002t/LITHIUM_BOARD/Lithium_Footprints/LIB_PMR18EZPFV2L00/PMR18EZPFV2L00/3D/PMR18EZPFV2L00.stp

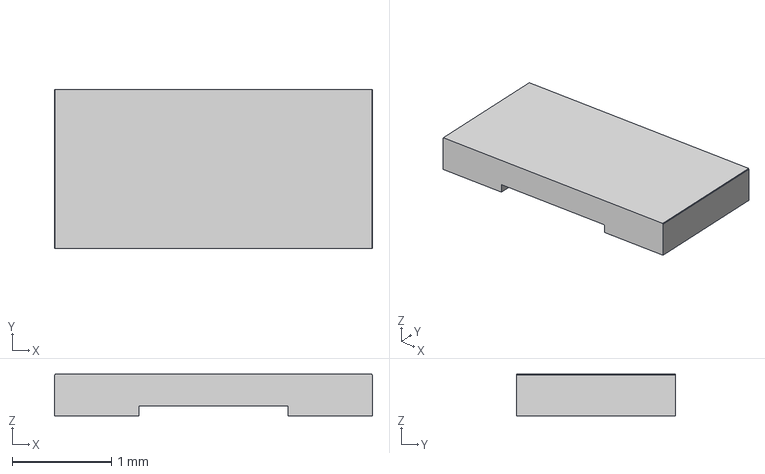
[picture p31: CAD file, 2026-05-30]
Lithium_Footprints/LIB_PMR18EZPFV2L00/PMR18EZPFV2L00/3D/PMR18EZPFV2L00.stp
3.20 x 1.60 x 0.42 mm
