tommy2002t/LITHIUM_BOARD/Lithium_Footprints/LIB_RC0603FR-0710ML/RC0603FR-0710ML/3D/RC0603FR-0710ML.stp

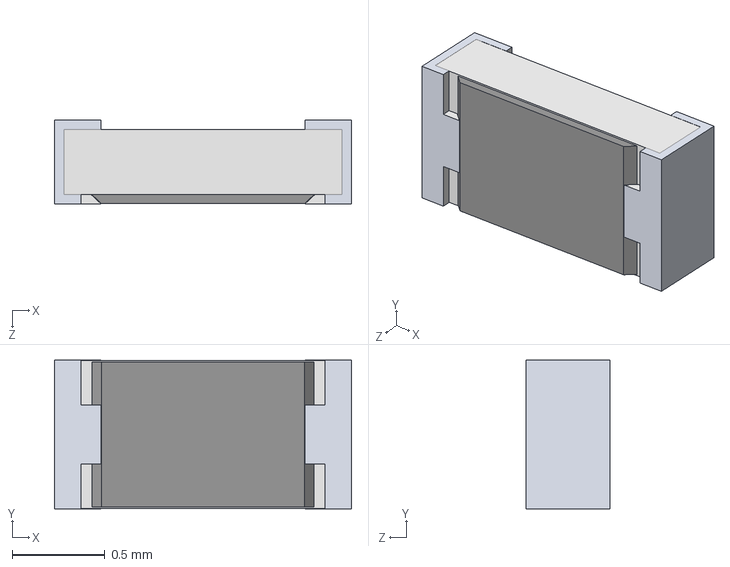
[picture p32: CAD file, 2026-05-30]
Lithium_Footprints/LIB_RC0603FR-0710ML/RC0603FR-0710ML/3D/RC0603FR-0710ML.stp
1.60 x 0.8 x 0.45 mm
