tommy2002t/LITHIUM_BOARD/Lithium_Footprints/LIB_RC0603FR-071KL/RC0603FR-071KL/3D/RC0603FR-071KL.stp

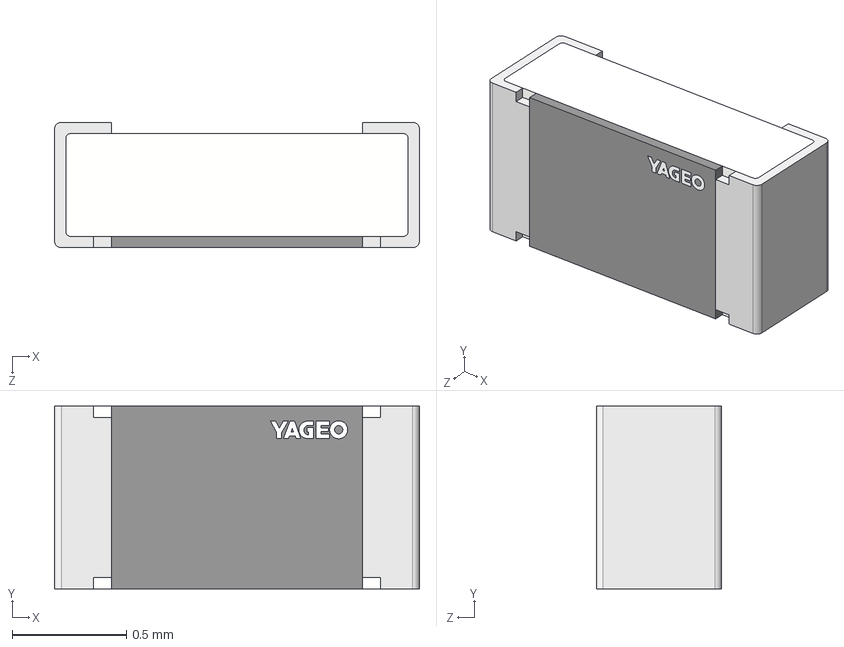
[picture p33: CAD file, 2026-05-30]
Lithium_Footprints/LIB_RC0603FR-071KL/RC0603FR-071KL/3D/RC0603FR-071KL.stp
1.60 x 0.8 x 0.55 mm
Yageo Logo
