tommy2002t/LITHIUM_BOARD/Lithium_Footprints/LIB_RT0603BRD07249KL/RT0603BRD07249KL/3D/RT0603BRD07249KL.stp

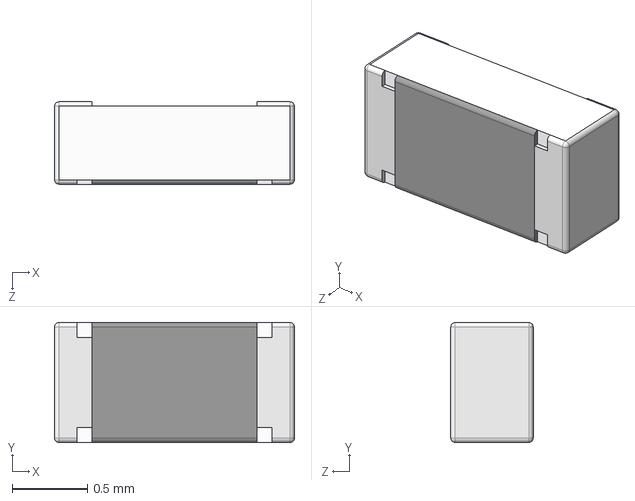
[picture p34: CAD file, 2026-05-30]
Lithium_Footprints/LIB_RT0603BRD07249KL/RT0603BRD07249KL/3D/RT0603BRD07249KL.stp
1.60 x 0.8 x 0.55 mm
