tommy2002t/LITHIUM_BOARD/Lithium_Footprints/LIB_RT0603BRD0735K2L/RT0603BRD0735K2L/3D/RT0603BRD0735K2L.stp

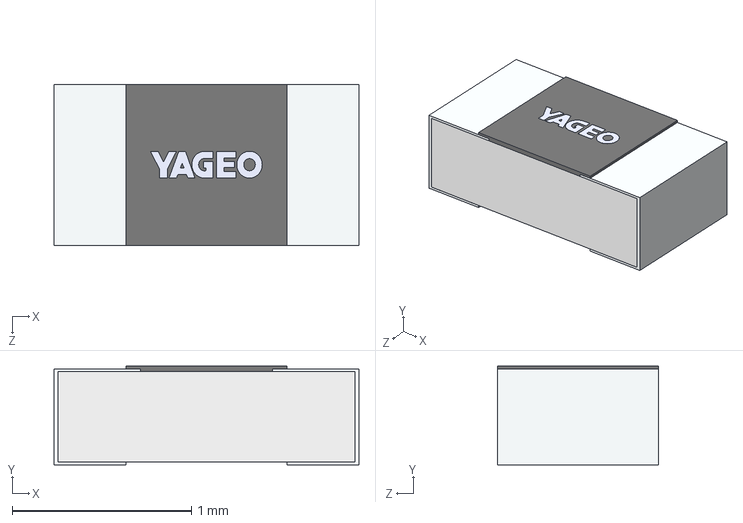
[picture p35: CAD file, 2026-07-15]
Lithium_Footprints/LIB_RT0603BRD0735K2L/RT0603BRD0735K2L/3D/RT0603BRD0735K2L.stp
1.70 x 0.55 x 0.9 mm
