tommy2002t/LITHIUM_BOARD/Lithium_Footprints/LIB_S3B-XH-SM4-TB_LF__SN_/S3B-XH-SM4-TB_LF__SN_/3D/S3B-XH-SM4-TB_LF__SN_.stp

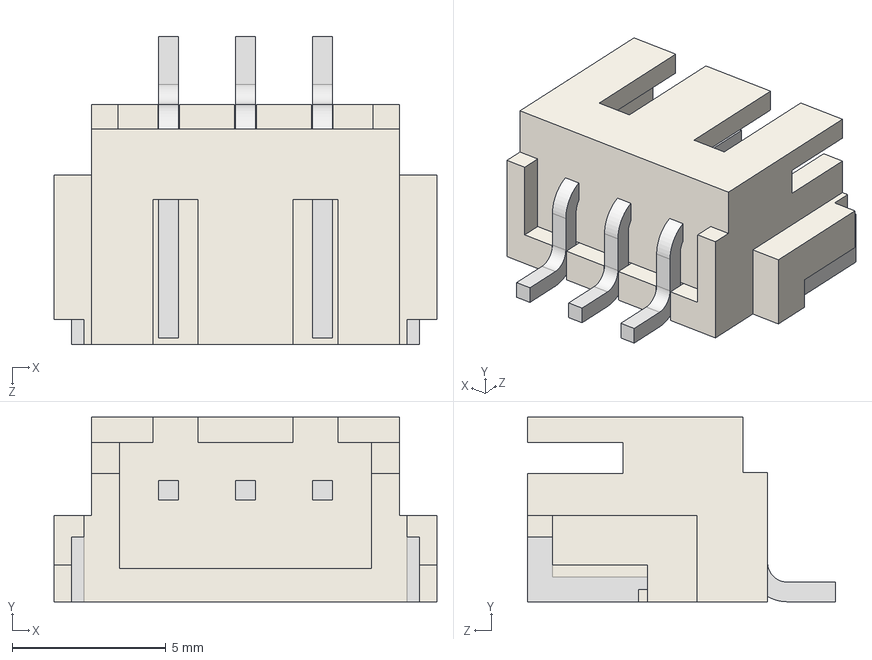
[picture p36: CAD file, 2026-06-06]
Lithium_Footprints/LIB_S3B-XH-SM4-TB_LF__SN_/S3B-XH-SM4-TB_LF__SN_/3D/S3B-XH-SM4-TB_LF__SN_.stp
12.5 x 6.00 x 10.0 mm
