tommy2002t/LITHIUM_BOARD/Lithium_Footprints/LIB_SIR870ADP-T1-GE3/SIR870ADP-T1-GE3/3D/POWERPAK_SO-8_SINGLE_VIS.step

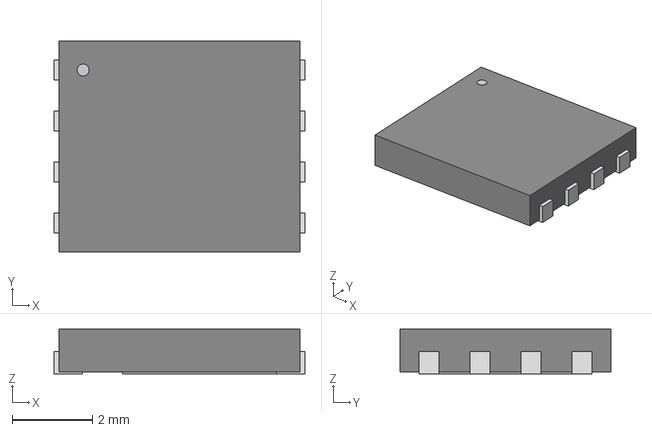
[picture p37: CAD file, 2026-07-05]
Lithium_Footprints/LIB_SIR870ADP-T1-GE3/SIR870ADP-T1-GE3/3D/POWERPAK_SO-8_SINGLE_VIS.step
6.25 x 5.26 x 1.12 mm
