tommy2002t/LITHIUM_BOARD/Lithium_Footprints/LIB_SRP1038A-100M/SRP1038A-100M/3D/SRP1038A-100M.stp

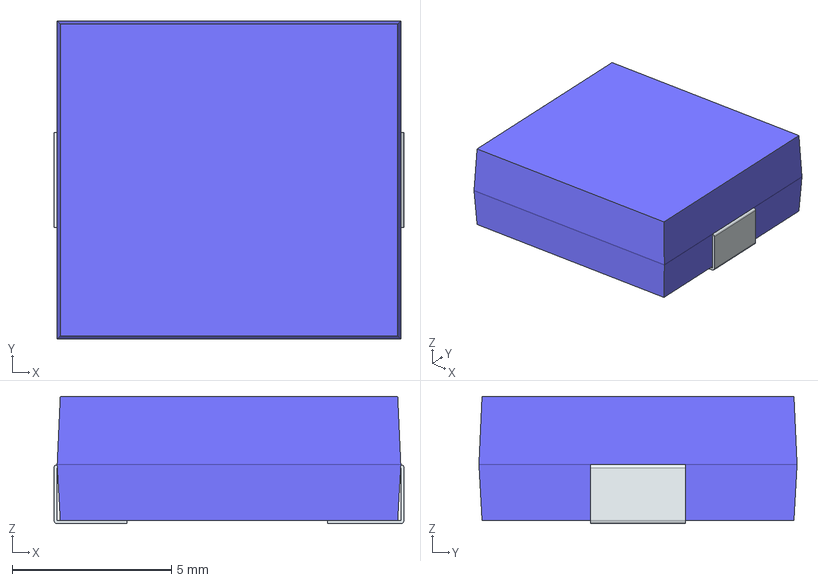
[picture p38: CAD file, 2026-05-30]
Lithium_Footprints/LIB_SRP1038A-100M/SRP1038A-100M/3D/SRP1038A-100M.stp
11.0 x 10.0 x 4.00 mm
FilletPin1
FilletPin2
