tommy2002t/LITHIUM_BOARD/Lithium_Footprints/LIB_STM32G030K6T6/STM32G030K6T6/3D/STM32G030K6T6.stp

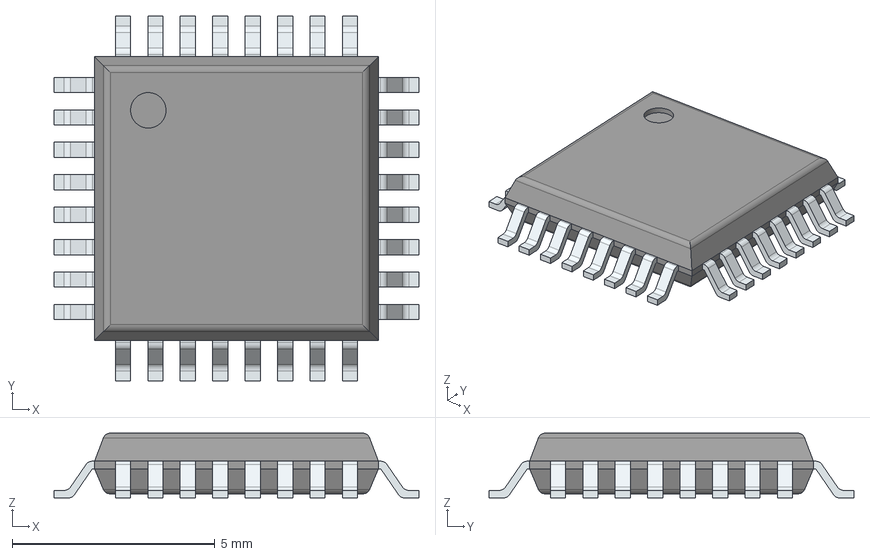
[picture p39: CAD file, 2026-05-30]
Lithium_Footprints/LIB_STM32G030K6T6/STM32G030K6T6/3D/STM32G030K6T6.stp
9.00 x 9.00 x 1.60 mm
PinsArrayLR
PinsArrayTB
