tommy2002t/LITHIUM_BOARD/Lithium_Footprints/LIB_STM32G0B1CBT6N/STM32G0B1CBT6N/3D/STM32G0B1CBT6N.stp

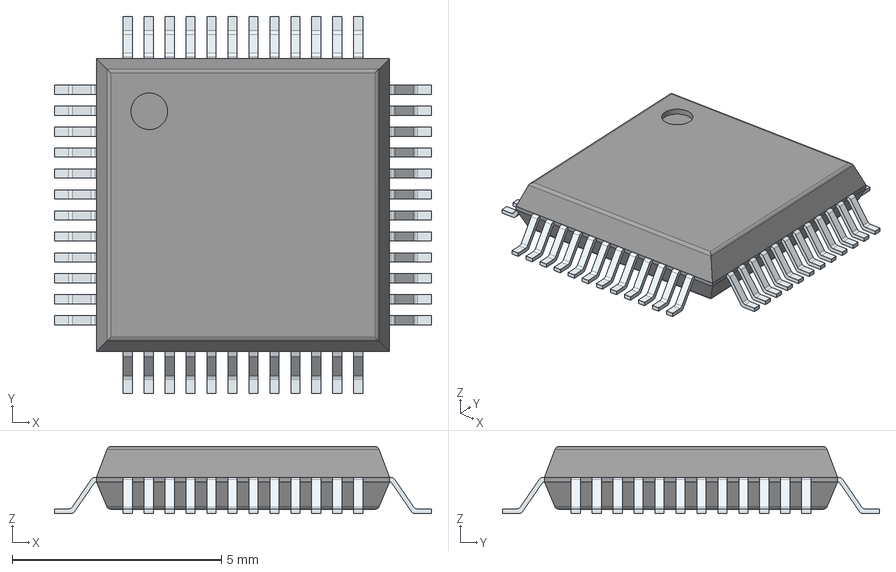
[picture p40: CAD file, 2026-06-06]
Lithium_Footprints/LIB_STM32G0B1CBT6N/STM32G0B1CBT6N/3D/STM32G0B1CBT6N.stp
9.00 x 9.00 x 1.60 mm
PinsArrayLR
PinsArrayTB
