tommy2002t/LITHIUM_BOARD/Lithium_Footprints/LIB_TCAN1044AEVDRQ1/TCAN1044AEVDRQ1/3D/TCAN1044AEVDRQ1.stp

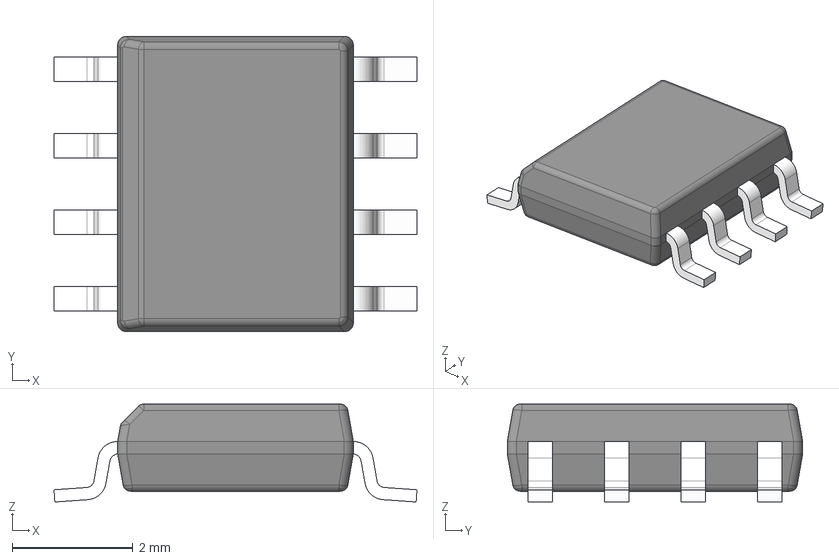
[picture p41: CAD file, 2026-06-06]
Lithium_Footprints/LIB_TCAN1044AEVDRQ1/TCAN1044AEVDRQ1/3D/TCAN1044AEVDRQ1.stp
6.02 x 4.90 x 1.63 mm
BODY-SO
LEAD-D0008A x 8
