tommy2002t/LITHIUM_BOARD/Lithium_Footprints/LIB_TCAN3414DDFR/TCAN3414DDFR/3D/TCAN3414DDFR.stp

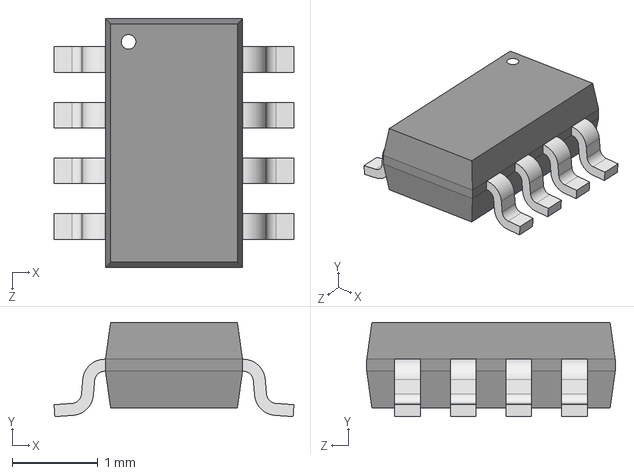
[picture p42: CAD file, 2026-07-23]
Lithium_Footprints/LIB_TCAN3414DDFR/TCAN3414DDFR/3D/TCAN3414DDFR.stp
2.80 x 1.10 x 2.90 mm
