tommy2002t/LITHIUM_BOARD/Lithium_Footprints/LIB_TSW-105-07-G-S/TSW-105-07-G-S/3D/TSW-105-07-G-S.stp

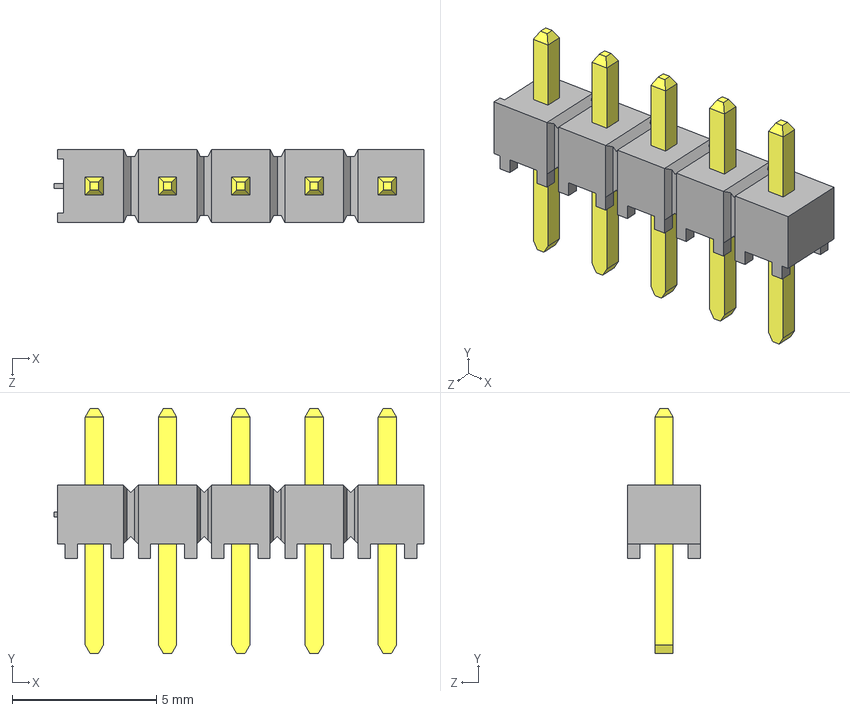
[picture p43: CAD file, 2026-05-30]
Lithium_Footprints/LIB_TSW-105-07-G-S/TSW-105-07-G-S/3D/TSW-105-07-G-S.stp
12.8 x 8.51 x 2.54 mm
T-1S6-21-TSW-1-05-5-S
TSW-105-05-G-S_body
