tommy2002t/LITHIUM_BOARD/Lithium_Footprints/LIB_UMJ325AB7475KMHP/UMJ325AB7475KMHP/3D/UMJ325AB7475KMHP.stp

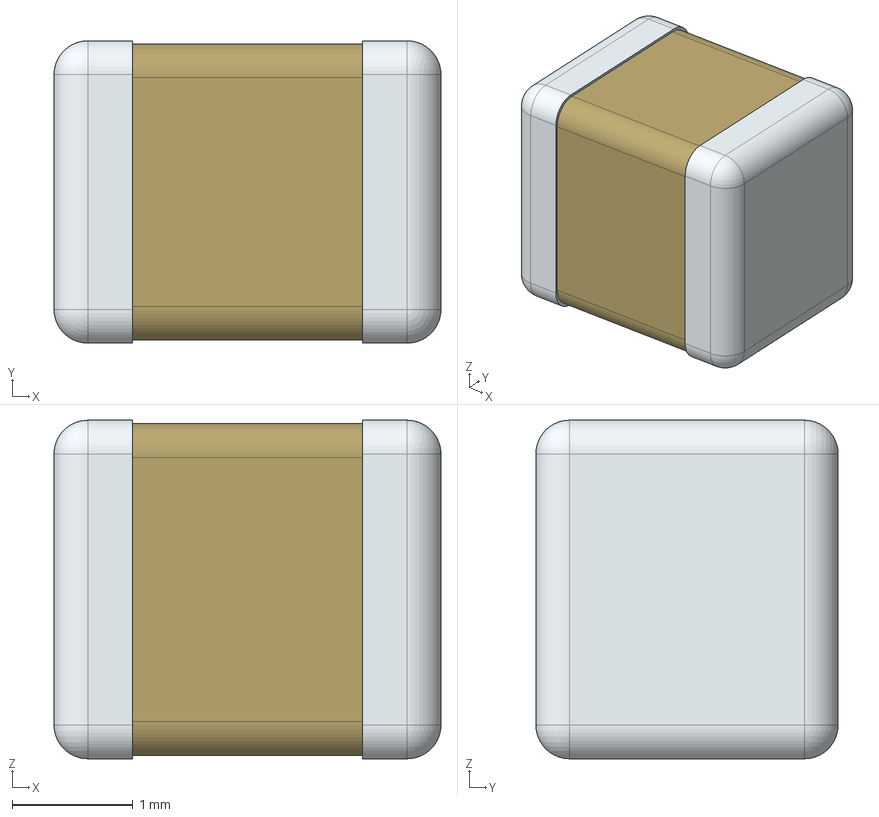
[picture p44: CAD file, 2026-05-30]
Lithium_Footprints/LIB_UMJ325AB7475KMHP/UMJ325AB7475KMHP/3D/UMJ325AB7475KMHP.stp
3.20 x 2.50 x 2.80 mm
