tommy2002t/LITHIUM_BOARD/Lithium_Footprints/LIB_VT1206BRD071ML/VT1206BRD071ML/3D/VT1206BRD071ML.stp

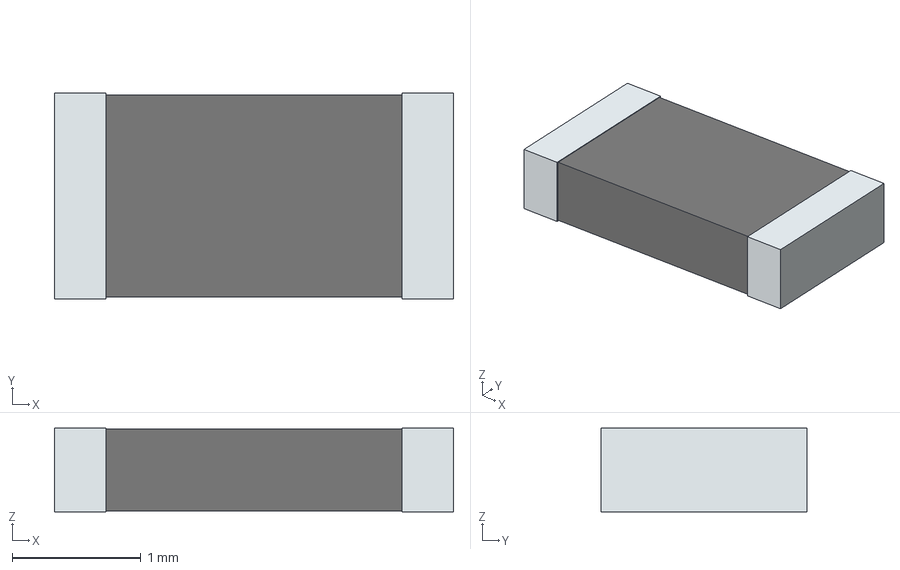
[picture p45: CAD file, 2026-05-30]
Lithium_Footprints/LIB_VT1206BRD071ML/VT1206BRD071ML/3D/VT1206BRD071ML.stp
3.10 x 1.60 x 0.65 mm
term1
term2
