tommy2002t/LITHIUM_BOARD/Lithium_Footprints/LIB_XT30PW-F/XT30PW-F/3D/XT30PW-F.stp

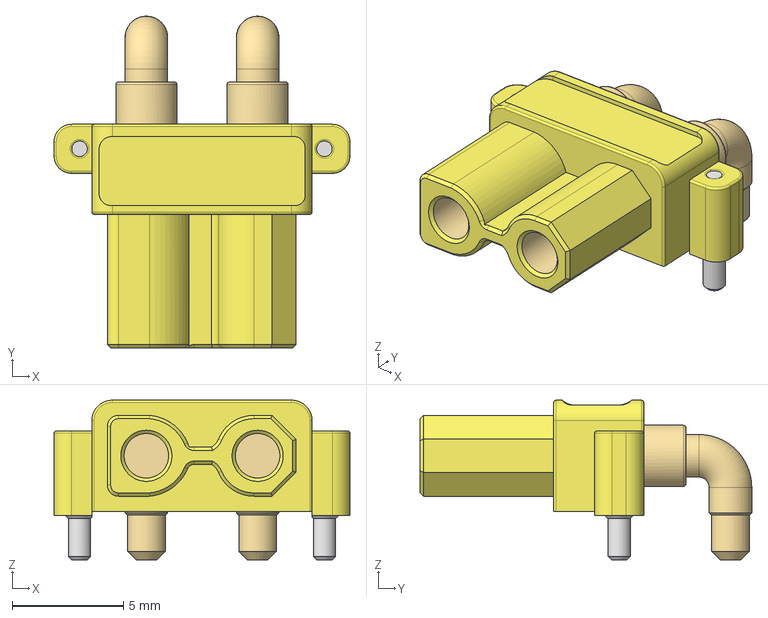
[picture p46: CAD file, 2026-05-30]
Lithium_Footprints/LIB_XT30PW-F/XT30PW-F/3D/XT30PW-F.stp
13.3 x 14.9 x 7.18 mm
