tommy2002t/LITHIUM_BOARD/Lithium_Footprints/LIB_XT30PW-M/XT30PW-M/3D/XT30PW-M.stp

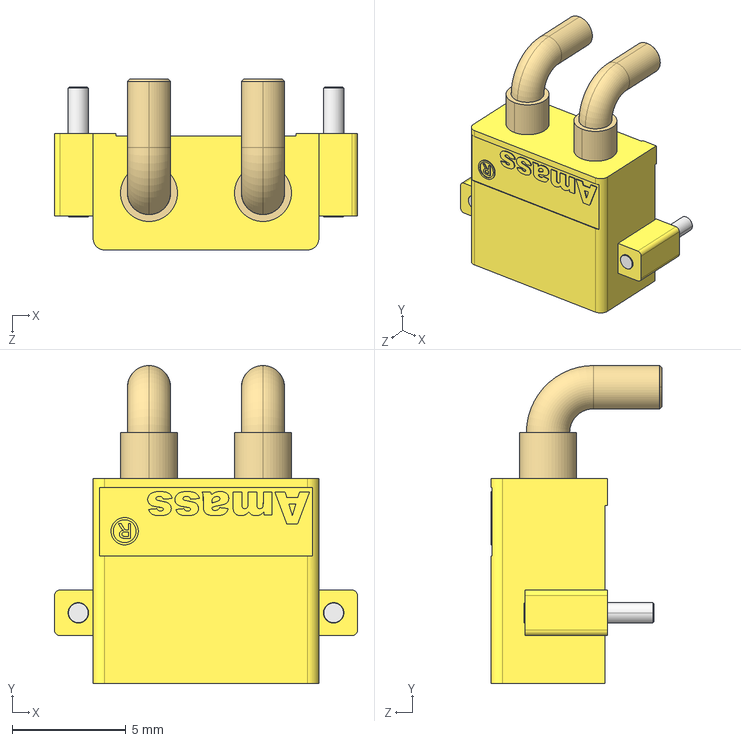
[picture p47: CAD file, 2026-05-30]
Lithium_Footprints/LIB_XT30PW-M/XT30PW-M/3D/XT30PW-M.stp
13.3 x 13.9 x 7.50 mm
