tommy2002t/LITHIUM_BOARD/(list of files, cad)

Other CAD files:
Lithium_Footprints/LIB_LTST-C190KRKT/LTST-C190KRKT/3D/LTST-C190KRKT.stp
Lithium_Footprints/LIB_STM32G0B1CET6N/STM32G0B1CET6N/3D/STM32G0B1CET6N.stp
Lithium_Footprints/LIB_SZBZX84C15LT3G/SZBZX84C15LT3G/3D/SZBZX84C15LT3G.stp
Lithium_Footprints/LIB_1N4148WQ-7-F/1N4148WQ-7-F/Allegro/sod3716x145n.psm
Lithium_Footprints/LIB_1N4148WQ-7-F/1N4148WQ-7-F/DEHDL/1n4148wq_7_f/chips/chips.prt
Lithium_Footprints/LIB_ACT45B-101-2P-TL003/ACT45B-101-2P-TL003/Allegro/act45b1012ptl003.psm
Lithium_Footprints/LIB_ACT45B-101-2P-TL003/ACT45B-101-2P-TL003/DEHDL/act45b_101_2p_tl003/chips/chips.prt
Lithium_Footprints/LIB_BQ25750RRVR/BQ25750RRVR/3D/BQ25750RRVR.stp
Lithium_Footprints/LIB_BQ25750RRVR/BQ25750RRVR/Allegro/qfn50p500x600x100-37n-d.psm
Lithium_Footprints/LIB_BQ25750RRVR/BQ25750RRVR/DEHDL/bq25750rrvr/chips/chips.prt
Lithium_Footprints/LIB_BQ7694204PFBR/BQ7694204PFBR/3D/BQ7694204PFBR.stp
Lithium_Footprints/LIB_BQ7694204PFBR/BQ7694204PFBR/Allegro/qfp50p900x900x120-48n.psm
Lithium_Footprints/LIB_BQ7694204PFBR/BQ7694204PFBR/DEHDL/bq7694204pfbr/chips/chips.prt
Lithium_Footprints/LIB_C0603C101J5GACTU/C0603C101J5GACTU/Allegro/capc1608x87n.psm
Lithium_Footprints/LIB_C0603C101J5GACTU/C0603C101J5GACTU/DEHDL/c0603c101j5gactu/chips/chips.prt
Lithium_Footprints/LIB_C0603C104K1RACAUTO/C0603C104K1RACAUTO/Allegro/capc1608x95n.psm
Lithium_Footprints/LIB_C0603C104K1RACAUTO/C0603C104K1RACAUTO/DEHDL/c0603c104k1racauto/chips/chips.prt
Lithium_Footprints/LIB_C0603C122K5RACTU/C0603C122K5RACTU/Allegro/c0603.psm
Lithium_Footprints/LIB_C0603C122K5RACTU/C0603C122K5RACTU/DEHDL/c0603c122k5ractu/chips/chips.prt
Lithium_Footprints/LIB_C0603C151J5GACTU/C0603C151J5GACTU/Allegro/capc1608x87n.psm
Lithium_Footprints/LIB_C0603C151J5GACTU/C0603C151J5GACTU/DEHDL/c0603c151j5gactu/chips/chips.prt
Lithium_Footprints/LIB_C0603C223K5RACTU/C0603C223K5RACTU/Allegro/c0603.psm
Lithium_Footprints/LIB_C0603C223K5RACTU/C0603C223K5RACTU/DEHDL/c0603c223k5ractu/chips/chips.prt
Lithium_Footprints/LIB_C0603C563K5RACTU/C0603C563K5RACTU/Allegro/c0603.psm
Lithium_Footprints/LIB_C0603C563K5RACTU/C0603C563K5RACTU/DEHDL/c0603c563k5ractu/chips/chips.prt
Lithium_Footprints/LIB_C0805C224K5RACTU/C0805C224K5RACTU/Allegro/c0805.psm
Lithium_Footprints/LIB_C0805C224K5RACTU/C0805C224K5RACTU/DEHDL/c0805c224k5ractu/chips/chips.prt
Lithium_Footprints/LIB_C0805X474K5RECAUTO/C0805X474K5RECAUTO/Allegro/c0805.psm
Lithium_Footprints/LIB_C0805X474K5RECAUTO/C0805X474K5RECAUTO/DEHDL/c0805x474k5recauto/chips/chips.prt
Lithium_Footprints/LIB_C1206C225K5RACTU/C1206C225K5RACTU/Allegro/c1206.psm
Lithium_Footprints/LIB_C1206C225K5RACTU/C1206C225K5RACTU/DEHDL/c1206c225k5ractu/chips/chips.prt
Lithium_Footprints/LIB_C1210C154K5RACTU/C1210C154K5RACTU/Allegro/c1210.psm
Lithium_Footprints/LIB_C1210C154K5RACTU/C1210C154K5RACTU/DEHDL/c1210c154k5ractu/chips/chips.prt
Lithium_Footprints/LIB_C2012X7R1H105K125AB/C2012X7R1H105K125AB/Allegro/c2012_commercial.psm
Lithium_Footprints/LIB_C2012X7R1H105K125AB/C2012X7R1H105K125AB/DEHDL/c2012x7r1h105k125ab/chips/chips.prt
Lithium_Footprints/LIB_CC0603KRX7R9BB104/CC0603KRX7R9BB104/Allegro/capc1608x90n.psm
Lithium_Footprints/LIB_CC0603KRX7R9BB104/CC0603KRX7R9BB104/DEHDL/cc0603krx7r9bb104/chips/chips.prt
Lithium_Footprints/LIB_CDBMT2100-HF/CDBMT2100-HF/Allegro/sodfl3516x100n.psm
Lithium_Footprints/LIB_CDBMT2100-HF/CDBMT2100-HF/DEHDL/cdbmt2100_hf/chips/chips.prt
Lithium_Footprints/LIB_CDSOT23-T24CAN/CDSOT23-T24CAN/Allegro/sot95p230x117-3n.psm
Lithium_Footprints/LIB_CDSOT23-T24CAN/CDSOT23-T24CAN/DEHDL/cdsot23_t24can/chips/chips.prt
Lithium_Footprints/LIB_CGA5L2X7R2A474K160AA/CGA5L2X7R2A474K160AA/Allegro/capc3216x190n.psm
Lithium_Footprints/LIB_CGA5L2X7R2A474K160AA/CGA5L2X7R2A474K160AA/DEHDL/cga5l2x7r2a474k160aa/chips/chips.prt
Lithium_Footprints/LIB_CL31B225KCHSNNE/CL31B225KCHSNNE/Allegro/capc3216x180n.psm
Lithium_Footprints/LIB_CL31B225KCHSNNE/CL31B225KCHSNNE/DEHDL/cl31b225kchsnne/chips/chips.prt
Lithium_Footprints/LIB_CL32B106KBVVPLE/CL32B106KBVVPLE/Allegro/capc3225x285n.psm
Lithium_Footprints/LIB_CL32B106KBVVPLE/CL32B106KBVVPLE/DEHDL/cl32b106kbvvple/chips/chips.prt
Lithium_Footprints/LIB_EEE-FT1V101AP/EEE-FT1V101AP/Allegro/eee1aa101sp.psm
Lithium_Footprints/LIB_EEE-FT1V101AP/EEE-FT1V101AP/DEHDL/eee_ft1v101ap/chips/chips.prt
Lithium_Footprints/LIB_EEE-TP1K391V/EEE-TP1K391V/DEHDL/eee_tp1k391v/chips/chips.prt
Lithium_Footprints/LIB_EEH-ZL1E151P/EEH-ZL1E151P/Allegro/eeehp1h4r7p.psm
Lithium_Footprints/LIB_EEH-ZL1E151P/EEH-ZL1E151P/DEHDL/eeh_zl1e151p/chips/chips.prt
Lithium_Footprints/LIB_EEV-FK2A101V/EEV-FK2A101V/DEHDL/eev_fk2a101v/chips/chips.prt
Lithium_Footprints/LIB_ERJ-2RKF60R4X/ERJ-2RKF60R4X/Allegro/erj2rkd1004x.psm
Lithium_Footprints/LIB_ERJ-2RKF60R4X/ERJ-2RKF60R4X/DEHDL/erj_2rkf60r4x/chips/chips.prt
Lithium_Footprints/LIB_ERJ-3GEY0R00V/ERJ-3GEY0R00V/Allegro/erj3ekf1000v.psm
Lithium_Footprints/LIB_ERJ-3GEY0R00V/ERJ-3GEY0R00V/DEHDL/erj_3gey0r00v/chips/chips.prt
Lithium_Footprints/LIB_ESDCAN24-2BLY/ESDCAN24-2BLY/Allegro/sot95p255x125-3n.psm
Lithium_Footprints/LIB_ESDCAN24-2BLY/ESDCAN24-2BLY/DEHDL/esdcan24_2bly/chips/chips.prt
Lithium_Footprints/LIB_GCM188R71H103KA37J/GCM188R71H103KA37J/DEHDL/gcm188r71h103ka37j/chips/chips.prt
Lithium_Footprints/LIB_GRM155R71H104KE14J/GRM155R71H104KE14J/DEHDL/grm155r71h104ke14j/chips/chips.prt
Lithium_Footprints/LIB_GRM188R72A472KA01D/GRM188R72A472KA01D/DEHDL/grm188r72a472ka01d/chips/chips.prt
Lithium_Footprints/LIB_KAM32LR72A475KU/KAM32LR72A475KU/Allegro/capc3225x94n.psm
Lithium_Footprints/LIB_KAM32LR72A475KU/KAM32LR72A475KU/DEHDL/kam32lr72a475ku/chips/chips.prt
Lithium_Footprints/LIB_LTST-C190KGKT/LTST-C190KGKT/Allegro/ledc1608x80n.psm
Lithium_Footprints/LIB_LTST-C190KGKT/LTST-C190KGKT/DEHDL/ltst_c190kgkt/chips/chips.prt
Lithium_Footprints/LIB_LTST-C190KRKT/LTST-C190KRKT/Allegro/ledc1608x80n.psm
Lithium_Footprints/LIB_LTST-C190KRKT/LTST-C190KRKT/DEHDL/ltst_c190krkt/chips/chips.prt
Lithium_Footprints/LIB_MCP1792T-3302H_DB/MCP1792T-3302H_DB/Allegro/sot230p700x180-4n.psm
Lithium_Footprints/LIB_MCP1792T-3302H_DB/MCP1792T-3302H_DB/DEHDL/mcp1792t_3302h_db/chips/chips.prt
Lithium_Footprints/LIB_MMBT5551LT1G/MMBT5551LT1G/Allegro/sot96p237x111-3n.psm
Lithium_Footprints/LIB_MMBT5551LT1G/MMBT5551LT1G/DEHDL/mmbt5551lt1g/chips/chips.prt
Lithium_Footprints/LIB_PMR100HZPFU5L00/PMR100HZPFU5L00/Allegro/resc6432x67n.psm
Lithium_Footprints/LIB_PMR100HZPFU5L00/PMR100HZPFU5L00/DEHDL/pmr100hzpfu5l00/chips/chips.prt
Lithium_Footprints/LIB_PMR18EZPFV2L00/PMR18EZPFV2L00/Allegro/resc3216x59n.psm
Lithium_Footprints/LIB_PMR18EZPFV2L00/PMR18EZPFV2L00/DEHDL/pmr18ezpfv2l00/chips/chips.prt
Lithium_Footprints/LIB_PXN4R7-30QLJ/PXN4R7-30QLJ/Allegro/pxn8r330qlj.psm
Lithium_Footprints/LIB_PXN4R7-30QLJ/PXN4R7-30QLJ/DEHDL/pxn4r7_30qlj/chips/chips.prt
Lithium_Footprints/LIB_RC0603FR-07100KL/RC0603FR-07100KL/Allegro/resc1608x55n.psm
Lithium_Footprints/LIB_RC0603FR-07100KL/RC0603FR-07100KL/DEHDL/rc0603fr_07100kl/chips/chips.prt
Lithium_Footprints/LIB_RC0603FR-07100RL/RC0603FR-07100RL/Allegro/resc1608x55n.psm
Lithium_Footprints/LIB_RC0603FR-07100RL/RC0603FR-07100RL/DEHDL/rc0603fr_07100rl/chips/chips.prt
Lithium_Footprints/LIB_RC0603FR-0710KL/RC0603FR-0710KL/Allegro/resc1608x55n.psm
Lithium_Footprints/LIB_RC0603FR-0710KL/RC0603FR-0710KL/DEHDL/rc0603fr_0710kl/chips/chips.prt
Lithium_Footprints/LIB_RC0603FR-0710ML/RC0603FR-0710ML/Allegro/resc1608x55n.psm
Lithium_Footprints/LIB_RC0603FR-0710ML/RC0603FR-0710ML/DEHDL/rc0603fr_0710ml/chips/chips.prt
Lithium_Footprints/LIB_RC0603FR-0710RL/RC0603FR-0710RL/DEHDL/rc0603fr_0710rl/chips/chips.prt
Lithium_Footprints/LIB_RC0603FR-07150RL/RC0603FR-07150RL/Allegro/resc1608x55n.psm
Lithium_Footprints/LIB_RC0603FR-07150RL/RC0603FR-07150RL/DEHDL/rc0603fr_07150rl/chips/chips.prt
Lithium_Footprints/LIB_RC0603FR-071KL/RC0603FR-071KL/Allegro/resc1608x55n.psm
Lithium_Footprints/LIB_RC0603FR-071KL/RC0603FR-071KL/DEHDL/rc0603fr_071kl/chips/chips.prt
Lithium_Footprints/LIB_RC0603FR-07249KL/RC0603FR-07249KL/Allegro/resc1608x55n.psm
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
