tommy2002t/LITHIUM_BOARD/(list of files, drawings)

Other design files:
Lithium_Footprints/LIB_1N4148WQ-7-F/1N4148WQ-7-F/Altium/1N4148WQ-7-F.SchLib
Lithium_Footprints/LIB_1N4148WQ-7-F/1N4148WQ-7-F/Altium/SOD3716X145N.PcbLib
Lithium_Footprints/LIB_ACT45B-101-2P-TL003/ACT45B-101-2P-TL003/Altium/ACT45B1012PTL003.PcbLib
Lithium_Footprints/LIB_ACT45B-101-2P-TL003/ACT45B-101-2P-TL003/Altium/ACT45B-101-2P-TL003.SchLib
Lithium_Footprints/LIB_BQ25750RRVR/BQ25750RRVR/Altium/BQ25750RRVR.SchLib
Lithium_Footprints/LIB_BQ25750RRVR/BQ25750RRVR/Altium/QFN50P500X600X100-37N-D.PcbLib
Lithium_Footprints/LIB_BQ7694204PFBR/BQ7694204PFBR/Altium/BQ7694204PFBR.SchLib
Lithium_Footprints/LIB_BQ7694204PFBR/BQ7694204PFBR/Altium/QFP50P900X900X120-48N.PcbLib
Lithium_Footprints/LIB_C0603C101J5GACTU/C0603C101J5GACTU/Altium/C0603C101J5GACTU.SchLib
Lithium_Footprints/LIB_C0603C101J5GACTU/C0603C101J5GACTU/Altium/CAPC1608X87N.PcbLib
Lithium_Footprints/LIB_C0603C104K1RACAUTO/C0603C104K1RACAUTO/Altium/C0603C104K1RACAUTO.SchLib
Lithium_Footprints/LIB_C0603C104K1RACAUTO/C0603C104K1RACAUTO/Altium/CAPC1608X95N.PcbLib
Lithium_Footprints/LIB_C0603C151J5GACTU/C0603C151J5GACTU/Altium/C0603C151J5GACTU.SchLib
Lithium_Footprints/LIB_C0603C151J5GACTU/C0603C151J5GACTU/Altium/CAPC1608X87N.PcbLib
Lithium_Footprints/LIB_C2012X7R1H105K125AB/C2012X7R1H105K125AB/Altium/C2012X7R1H105K125AB.SchLib
Lithium_Footprints/LIB_C2012X7R1H105K125AB/C2012X7R1H105K125AB/Altium/CAPC2012X145N.PcbLib
Lithium_Footprints/LIB_CC0603KRX7R9BB104/CC0603KRX7R9BB104/Altium/CAPC1608X90N.PcbLib
Lithium_Footprints/LIB_CC0603KRX7R9BB104/CC0603KRX7R9BB104/Altium/CC0603KRX7R9BB104.SchLib
Lithium_Footprints/LIB_CDBMT2100-HF/CDBMT2100-HF/Altium/CDBMT2100-HF.SchLib
Lithium_Footprints/LIB_CDBMT2100-HF/CDBMT2100-HF/Altium/SODFL3516X100N.PcbLib
Lithium_Footprints/LIB_CDSOT23-T24CAN/CDSOT23-T24CAN/Altium/CDSOT23-T24CAN.SchLib
Lithium_Footprints/LIB_CDSOT23-T24CAN/CDSOT23-T24CAN/Altium/SOT95P230X117-3N.PcbLib
Lithium_Footprints/LIB_CGA5L2X7R2A474K160AA/CGA5L2X7R2A474K160AA/Altium/CAPC3216X190N.PcbLib
Lithium_Footprints/LIB_CGA5L2X7R2A474K160AA/CGA5L2X7R2A474K160AA/Altium/CGA5L2X7R2A474K160AA.SchLib
Lithium_Footprints/LIB_CL31B225KCHSNNE/CL31B225KCHSNNE/Altium/CAPC3216X180N.PcbLib
Lithium_Footprints/LIB_CL31B225KCHSNNE/CL31B225KCHSNNE/Altium/CL31B225KCHSNNE.SchLib
Lithium_Footprints/LIB_CL32B106KBVVPLE/CL32B106KBVVPLE/Altium/CAPC3225X285N.PcbLib
Lithium_Footprints/LIB_CL32B106KBVVPLE/CL32B106KBVVPLE/Altium/CL32B106KBVVPLE.SchLib
Lithium_Footprints/LIB_ERJ-2RKF60R4X/ERJ-2RKF60R4X/Altium/ERJ2RKD1004X.PcbLib
Lithium_Footprints/LIB_ERJ-2RKF60R4X/ERJ-2RKF60R4X/Altium/ERJ-2RKF60R4X.SchLib
Lithium_Footprints/LIB_ESDCAN24-2BLY/ESDCAN24-2BLY/Altium/ESDCAN24-2BLY.SchLib
Lithium_Footprints/LIB_ESDCAN24-2BLY/ESDCAN24-2BLY/Altium/SOT95P255X125-3N.PcbLib
Lithium_Footprints/LIB_GCM188R71H103KA37J/GCM188R71H103KA37J/Altium/CAPC1608X90N.PcbLib
Lithium_Footprints/LIB_GCM188R71H103KA37J/GCM188R71H103KA37J/Altium/GCM188R71H103KA37J.SchLib
Lithium_Footprints/LIB_GRM188R72A472KA01D/GRM188R72A472KA01D/Altium/CAPC1608X90N.PcbLib
Lithium_Footprints/LIB_GRM188R72A472KA01D/GRM188R72A472KA01D/Altium/GRM188R72A472KA01D.SchLib
Lithium_Footprints/LIB_KAM32LR72A475KU/KAM32LR72A475KU/Altium/CAPC3225X94N.PcbLib
Lithium_Footprints/LIB_KAM32LR72A475KU/KAM32LR72A475KU/Altium/KAM32LR72A475KU.SchLib
Lithium_Footprints/LIB_LTST-C190KGKT/LTST-C190KGKT/Altium/LEDC1608X80N.PcbLib
Lithium_Footprints/LIB_LTST-C190KGKT/LTST-C190KGKT/Altium/LTST-C190KGKT.SchLib
Lithium_Footprints/LIB_LTST-C190KRKT/LTST-C190KRKT/Altium/LEDC1608X80N.PcbLib
Lithium_Footprints/LIB_LTST-C190KRKT/LTST-C190KRKT/Altium/LTST-C190KRKT.SchLib
Lithium_Footprints/LIB_MCP1792T-3302H_DB/MCP1792T-3302H_DB/Altium/MCP1792T-3302H_DB.SchLib
Lithium_Footprints/LIB_MCP1792T-3302H_DB/MCP1792T-3302H_DB/Altium/SOT230P700X180-4N.PcbLib
Lithium_Footprints/LIB_MMBT5551LT1G/MMBT5551LT1G/Altium/MMBT5551LT1G.SchLib
Lithium_Footprints/LIB_MMBT5551LT1G/MMBT5551LT1G/Altium/SOT96P237X111-3N.PcbLib
Lithium_Footprints/LIB_PMR18EZPFV2L00/PMR18EZPFV2L00/Altium/PMR18EZPFV2L00.SchLib
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
