tommy2002t/LITHIUM_BOARD/Lithium_Board.kicad_pcb

## KiCad design Lithium_Board.kicad_pcb (2026-07-24)

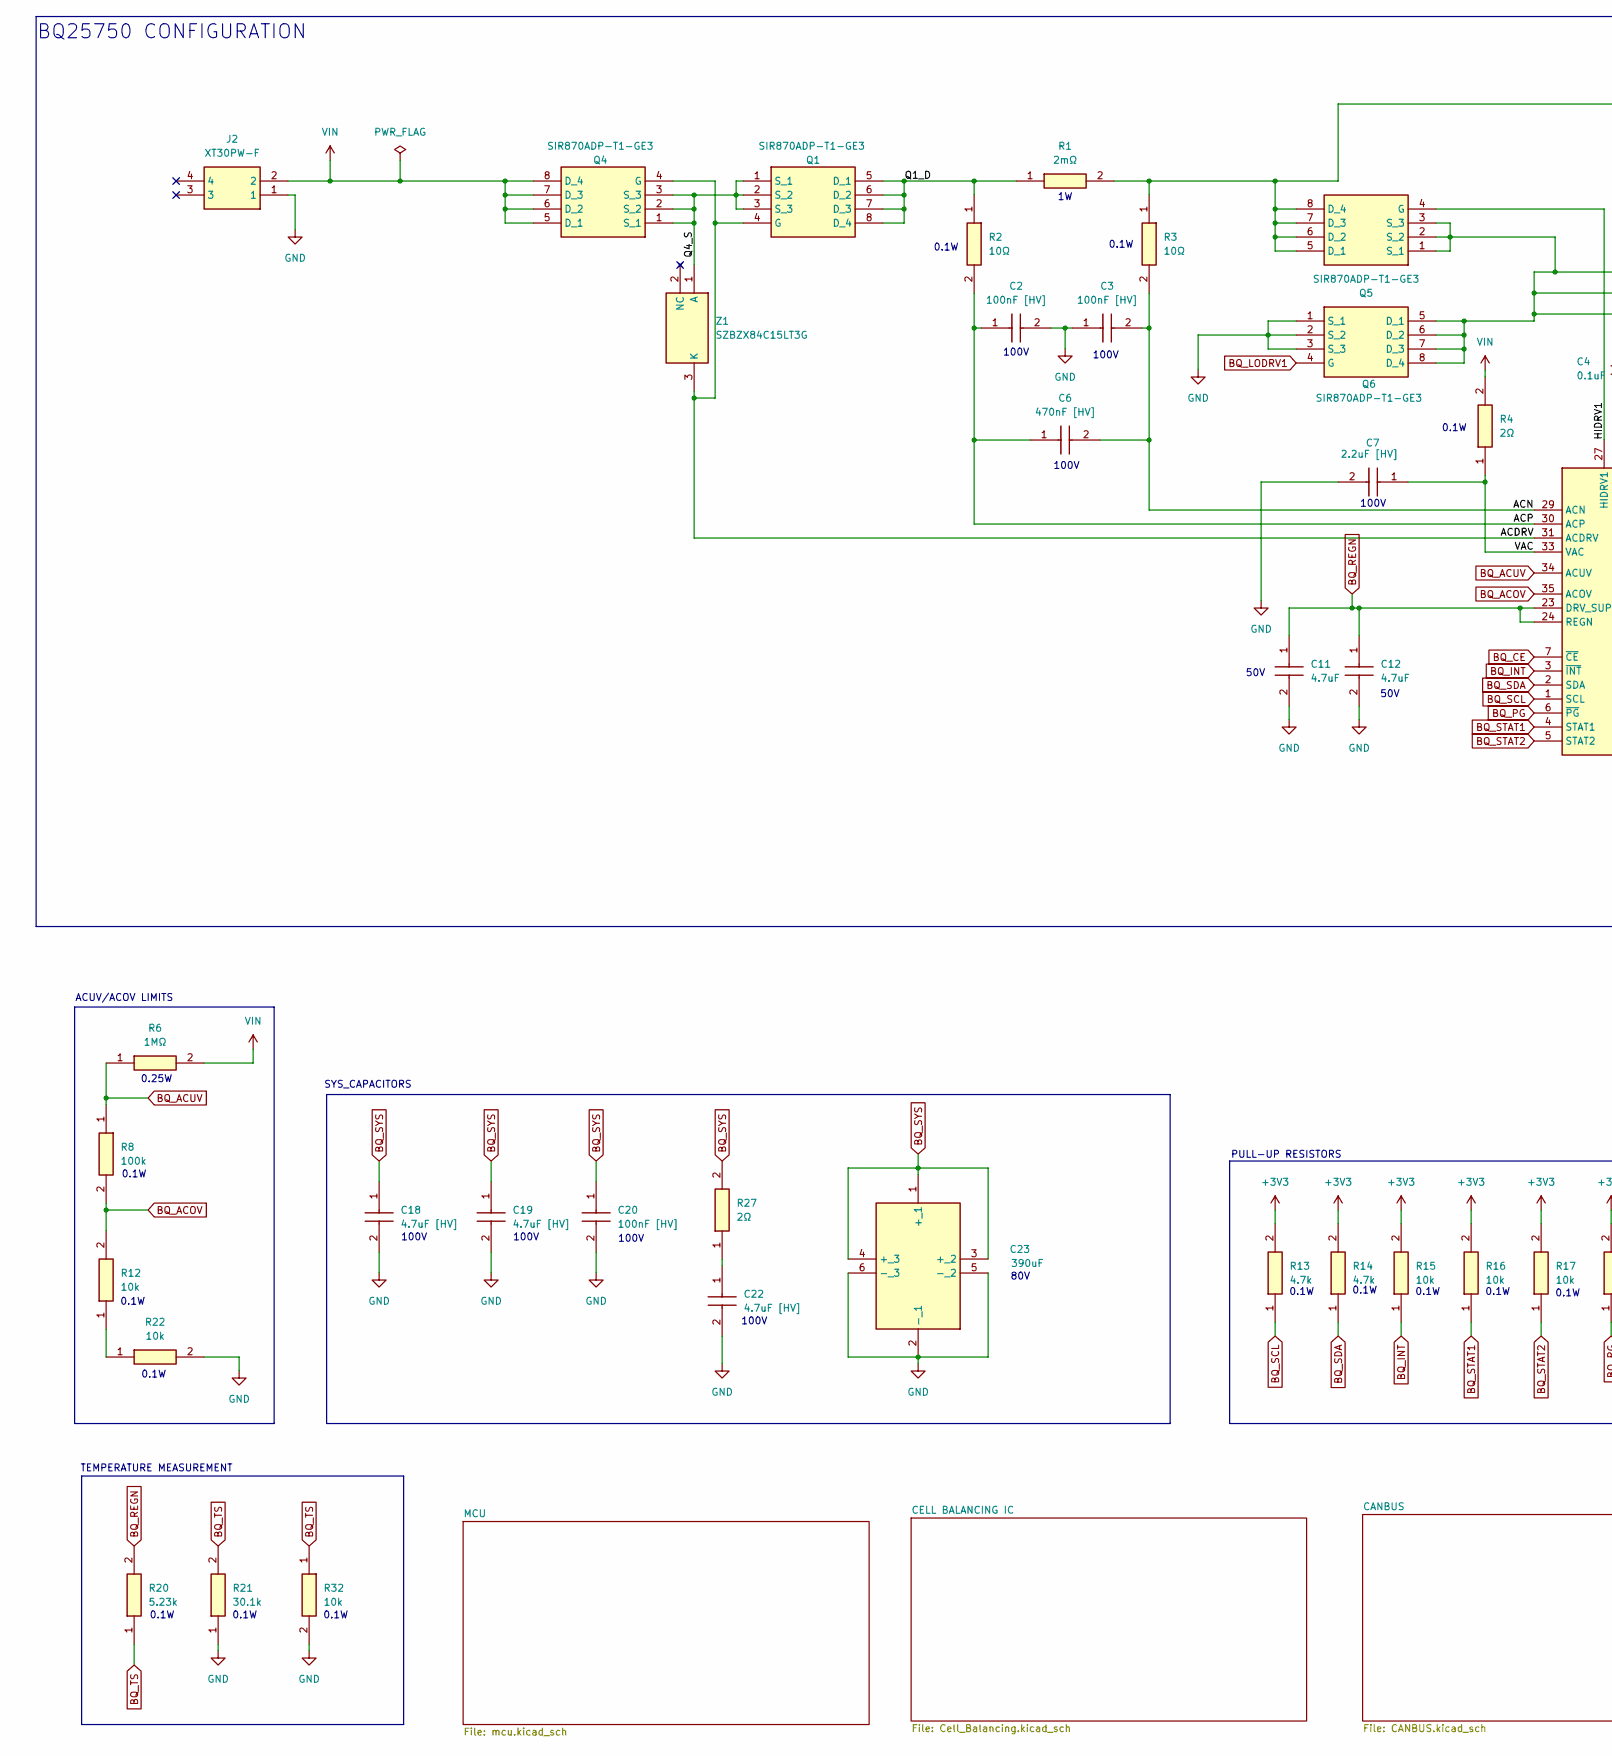
[picture p48: schematic Lithium_Board.kicad_sch, part in row 1, column 1]

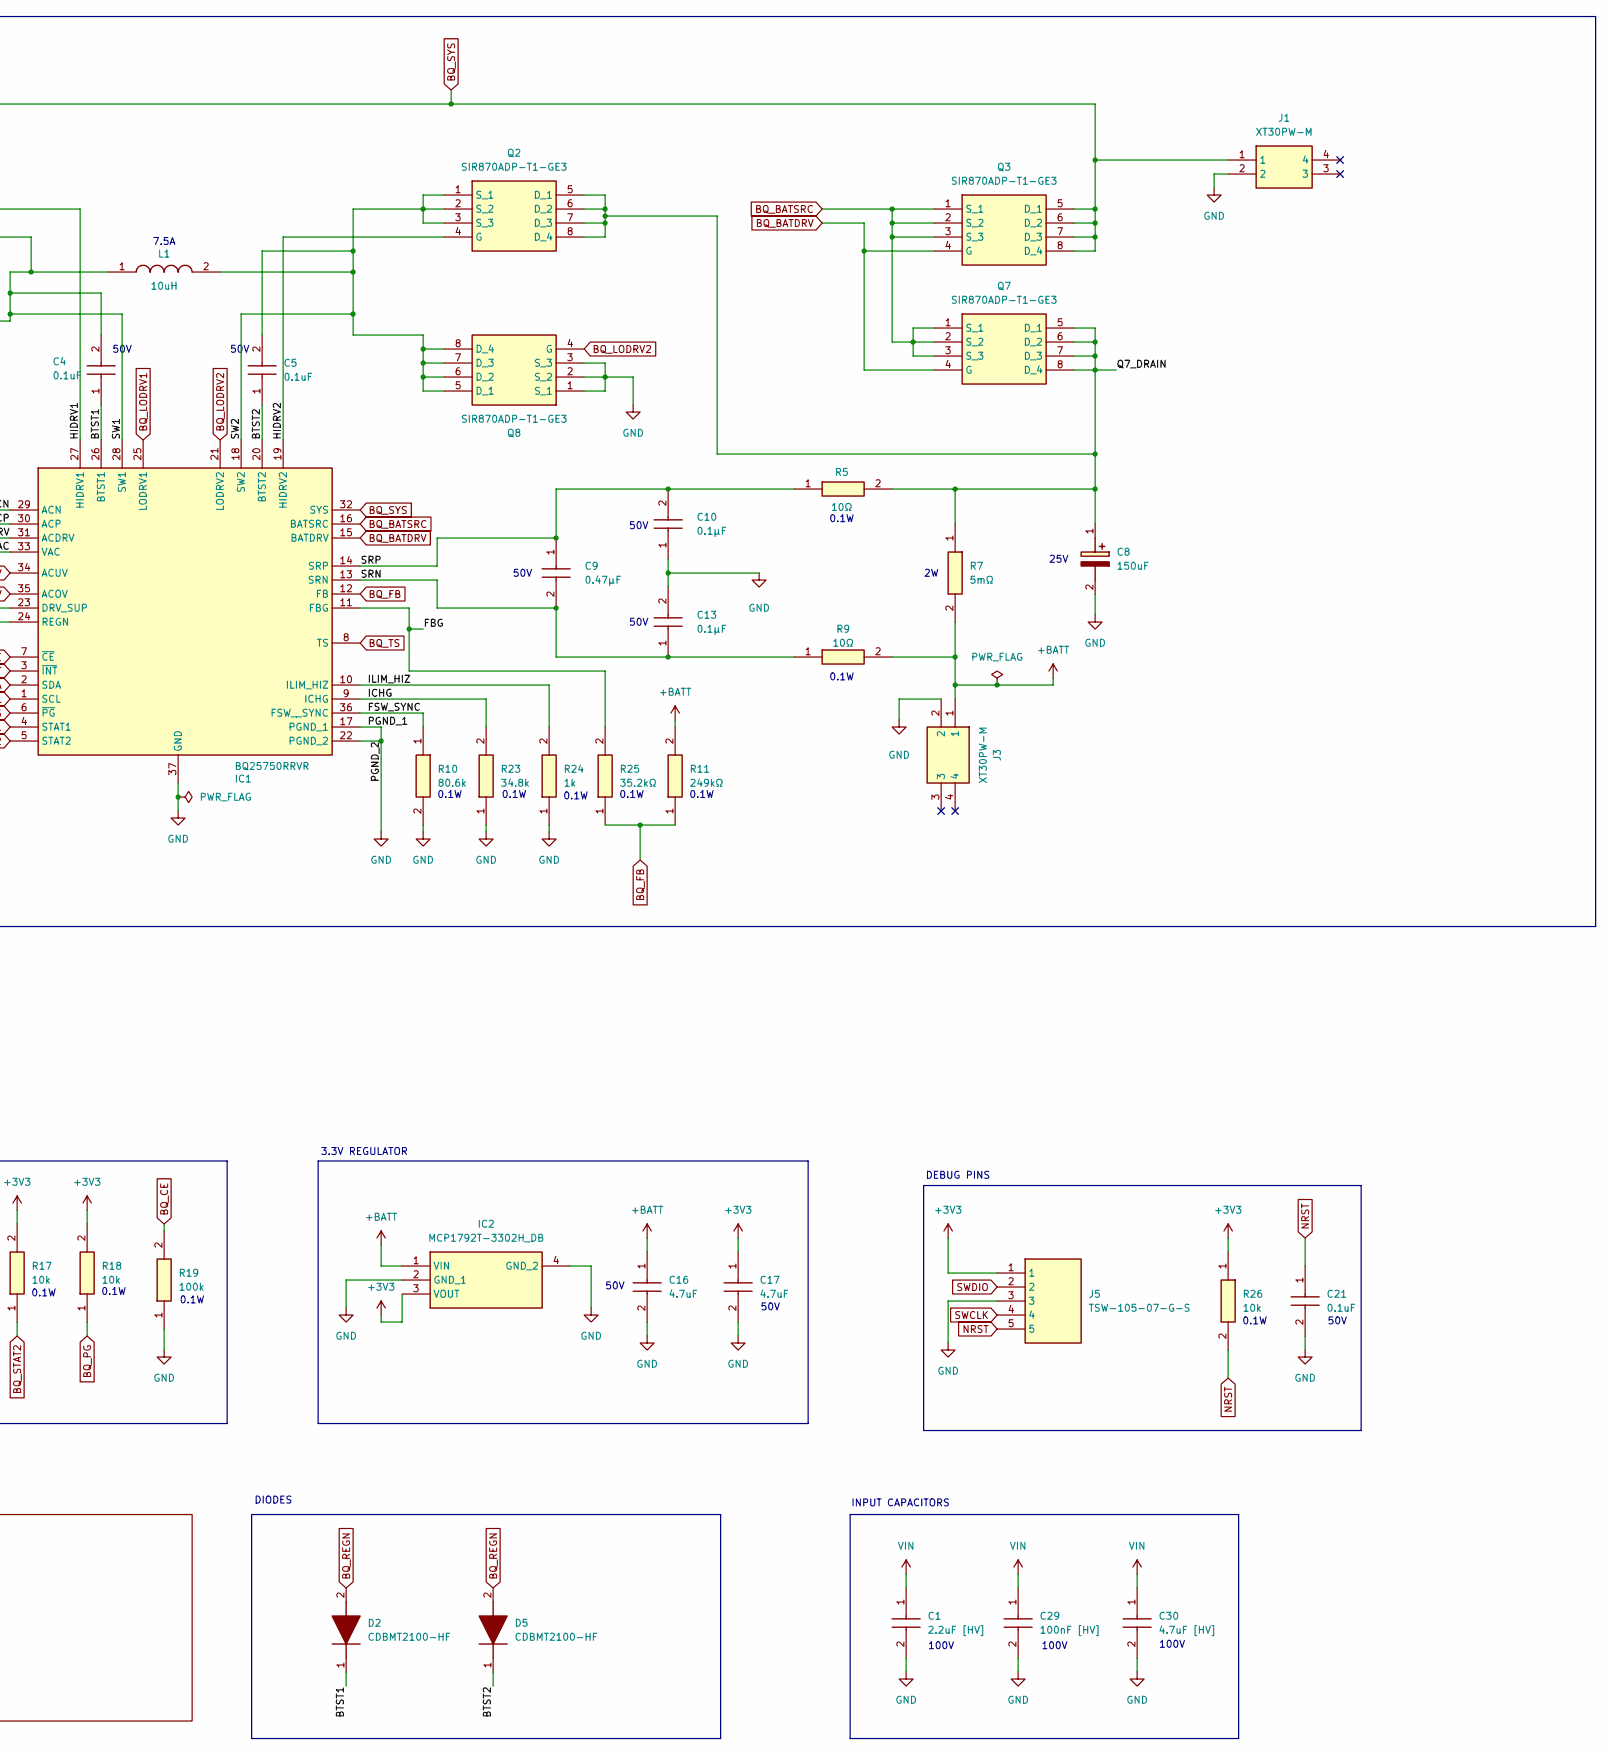
[picture p49: schematic Lithium_Board.kicad_sch, part in row 1, column 2]

Parts:
C1, C7: 2.2uF [HV]; CAPC3216X180N; Mouser Part Number 187-CL31B225KCHSNNE
C2, C3, C20, C29: 100nF [HV]; CAPC1608X95N; Mouser Part Number 80-C0603C104K1RAUTO
C4, C5, C21: 0.1uF; CAPC1608X90N; Mouser Part Number 603-CC603KRX7R9BB104
C6: 470nF [HV]; CAPC3216X190N; Mouser Part Number 810-CGA5L2X7R2A474K
C8: 150uF; EEEHP1H4R7P; Manufacturer_Part_Number EEH-ZL1E151P
C9: 0.47μF; C0805; Mouser Part Number 80-C0805X474K5REAUTO
C10, C13: 0.1μF; CAPC1608X90N; Mouser Part Number 603-CC603KRX7R9BB104
C11, C12, C16, C17: 4.7uF; CAPC3225X280N; Mouser Part Number 963-UMJ325AB7475KMHP
C18, C19, C22, C30: 4.7uF [HV]; CAPC3225X94N; Mouser Part Number 581-KAM32LR72A475KU
C23: 390uF; EEEFK0J682AV; Mouser Part Number 667-EEE-TP1K391V
D2, D5: CDBMT2100-HF; SODFL3516X100N; Mouser Part Number 750-CDBMT2100-HF
IC1: BQ25750RRVR; QFN50P500X600X100-37N-D; Mouser Part Number 595-BQ25750RRVR
IC2: MCP1792T-3302H_DB; SOT230P700X180-4N; Mouser Part Number 579-MCP1792T-3302HDB
J1, J3: XT30PW-M; XT30PWM; Manufacturer_Part_Number XT30PW-M
J2: XT30PW-F; XT30PWF; Manufacturer_Part_Number XT30PW-F
J5: TSW-105-07-G-S; TSW-105-XX-YY-S; Mouser Part Number 200-TSW10507GS
L1: 10uH; INDPM110100X400N; Mouser Part Number 652-SRP1038A-100M
Q1, Q2, Q3, Q4, Q5, Q6, Q7, Q8: SIR870ADP-T1-GE3; POWERPAK-SO-8; Mouser Part Number 78-SIR870ADP-T1-GE3
R1: 2mΩ; RESC3216X59N; Mouser Part Number 755-PMR18EZPFV2L00
R2, R3, R5, R9: 10Ω; RESC1608X55N; Mouser Part Number 603-RC0603FR-0710RL
R4, R27: 2Ω; RESC1608X55N; Mouser Part Number 603-RC0603FR-072RL
R6: 1MΩ; RESC3116X65N; Mouser Part Number 603-VT1206BRD071ML
R7: 5mΩ; RESC6432X67N; Mouser Part Number 755-PMR100HZPFU5L00
R8, R19: 100k; RESC1608X55N; Mouser Part Number 603-RC0603FR-07100KL
R10: 80.6k; RESC1608X55N; Mouser Part Number 603-RC0603FR-0780K6L
R11: 249kΩ; RESC1608X55N; Mouser Part Number 603-RT0603BRD07249KL
R12, R15, R16, R17, R18, R22, R26, R32: 10k; RESC1608X55N; Mouser Part Number 603-RC0603FR-0710KL
R13, R14: 4.7k; RESC1608X55N; Mouser Part Number 603-RC0603FR-074K7L
R20: 5.23k; RESC1608X55N; Mouser Part Number 603-RC0603FR-075K23L
R21: 30.1k; RESC1608X55N; Mouser Part Number 603-RC0603FR-0730K1L
R23: 34.8k; RESC1608X55N; Mouser Part Number 603-RC0603FR-0734K8L
R24: 1k; RESC1608X55N; Mouser Part Number 603-RC0603FR-071KL
R25: 35.2kΩ; RESC1608X55N; Manufacturer_Part_Number RT0603BRD0735K2L
Z1: SZBZX84C15LT3G; SOT96P237X111-3N; Mouser Part Number 863-SZBZX84C15LT3G

Connections:
+3V3: C17.1, IC2.3 (VOUT), J5.1, R13.2, R14.2, R15.2, R16.2, R17.2, R18.2, R26.1; also elsewhere on the board
+BATT: C16.1, IC2.1 (VIN), J3.1, R7.2, R9.2, R11.2
/ACDRV: IC1.31 (ACDRV), Q1.4 (G), Q4.4 (G), Z1.3 (K)
/ACN: C3.2, C6.2, IC1.29 (ACN), R3.2
/ACP: C2.1, C6.1, IC1.30 (ACP), R2.2
/BTST1: C4.1, D2.1 (K), IC1.26 (BTST1)
/BTST2: C5.1, D5.1 (K), IC1.20 (BTST2)
/FBG: IC1.11 (FBG), R25.2
/FSW_SYNC: IC1.36 (FSW__SYNC), R10.1
/HIDRV1: IC1.27 (HIDRV1), Q5.4 (G)
/HIDRV2: IC1.19 (HIDRV2), Q2.4 (G)
/ICHG: IC1.9 (ICHG), R23.2
/ILIM_HIZ: IC1.10 (ILIM_HIZ), R24.2
/Q1_D: Q1.5 (D_1), Q1.6 (D_2), Q1.7 (D_3), Q1.8 (D_4), R1.1, R2.1
/Q4_S: Q1.1 (S_1), Q1.2 (S_2), Q1.3 (S_3), Q4.1 (S_1), Q4.2 (S_2), Q4.3 (S_3), Z1.1 (A)
/Q7_DRAIN: C8.1 (+), Q2.5 (D_1), Q2.6 (D_2), Q2.7 (D_3), Q2.8 (D_4), Q7.5 (D_1), Q7.6 (D_2), Q7.7 (D_3), Q7.8 (D_4), R5.2, R7.1
/SRN: C9.2, C13.1, IC1.13 (SRN), R9.1
/SRP: C9.1, C10.2, IC1.14 (SRP), R5.1
/SW1: C4.2, IC1.28 (SW1), L1.1, Q5.1 (S_1), Q5.2 (S_2), Q5.3 (S_3), Q6.5 (D_1), Q6.6 (D_2), Q6.7 (D_3), Q6.8 (D_4)
/SW2: C5.2, IC1.18 (SW2), L1.2, Q2.1 (S_1), Q2.2 (S_2), Q2.3 (S_3), Q8.5 (D_1), Q8.6 (D_2), Q8.7 (D_3), Q8.8 (D_4)
/VAC: C7.1, IC1.33 (VAC), R4.1
BQ_ACOV: IC1.35 (ACOV), R8.2, R12.2
BQ_ACUV: IC1.34 (ACUV), R6.1, R8.1
BQ_BATDRV: IC1.15 (BATDRV), Q3.4 (G), Q7.4 (G)
BQ_BATSRC: IC1.16 (BATSRC), Q3.1 (S_1), Q3.2 (S_2), Q3.3 (S_3), Q7.1 (S_1), Q7.2 (S_2), Q7.3 (S_3)
BQ_CE: IC1.7 (~CE), R19.2; also elsewhere on the board
BQ_FB: IC1.12 (FB), R11.1, R25.1
BQ_INT: IC1.3 (~INT), R15.1; also elsewhere on the board
BQ_LODRV1: IC1.25 (LODRV1), Q6.4 (G)
BQ_LODRV2: IC1.21 (LODRV2), Q8.4 (G)
BQ_PG: IC1.6 (~PG), R18.1; also elsewhere on the board
BQ_REGN: C11.1, C12.1, D2.2 (A), D5.2 (A), IC1.23 (DRV_SUP), IC1.24 (REGN), R20.2
BQ_SCL: IC1.1 (SCL), R13.1; also elsewhere on the board
BQ_SDA: IC1.2 (SDA), R14.1; also elsewhere on the board
BQ_STAT1: IC1.4 (STAT1), R16.1; also elsewhere on the board
BQ_STAT2: IC1.5 (STAT2), R17.1; also elsewhere on the board
BQ_SYS: C18.1, C19.1, C20.1, C23.1 (+_1), C23.3 (+_2), C23.4 (+_3), IC1.32 (SYS), J1.1, Q3.5 (D_1), Q3.6 (D_2), Q3.7 (D_3), Q3.8 (D_4), Q5.5 (D_1), Q5.6 (D_2), Q5.7 (D_3), Q5.8 (D_4), R1.2, R3.1, R27.2
BQ_TS: IC1.8 (TS), R20.1, R21.2, R32.1; also elsewhere on the board
GND: C1.2, C2.2, C3.1, C7.2, C8.2 (-), C10.1, C11.2, C12.2, C13.2, C16.2, C17.2, C18.2, C19.2, C20.2, C21.2, C22.2, C23.2 (-_1), C23.5 (-_2), C23.6 (-_3), C29.2, C30.2, IC1.17 (PGND_1), IC1.22 (PGND_2), IC1.37 (GND), IC2.2 (GND_1), IC2.4 (GND_2), J1.2, J2.1, J3.2, J5.3, Q6.1 (S_1), Q6.2 (S_2), Q6.3 (S_3), Q8.1 (S_1), Q8.2 (S_2), Q8.3 (S_3), R10.2, R19.1, R21.1, R22.2, R23.1, R24.1, R32.2; also elsewhere on the board
NRST: C21.1, J5.5, R26.2; also elsewhere on the board
unnamed: C22.1, R27.1
unnamed: R12.1, R22.1
SWCLK: J5.4; also elsewhere on the board
SWDIO: J5.2; also elsewhere on the board
VIN: C1.1, C29.1, C30.1, J2.2, Q4.5 (D_1), Q4.6 (D_2), Q4.7 (D_3), Q4.8 (D_4), R4.2, R6.2

Notes on the sheet:
0.1W
TEMPERATURE MEASUREMENT
50V
ACUV/ACOV LIMITS
INPUT CAPACITORS
100V
PULL-UP RESISTORS
DEBUG PINS
7.5A
3.3V REGULATOR
DIODES
25V
80V
SYS_CAPACITORS
0.25W
BQ25750 CONFIGURATION

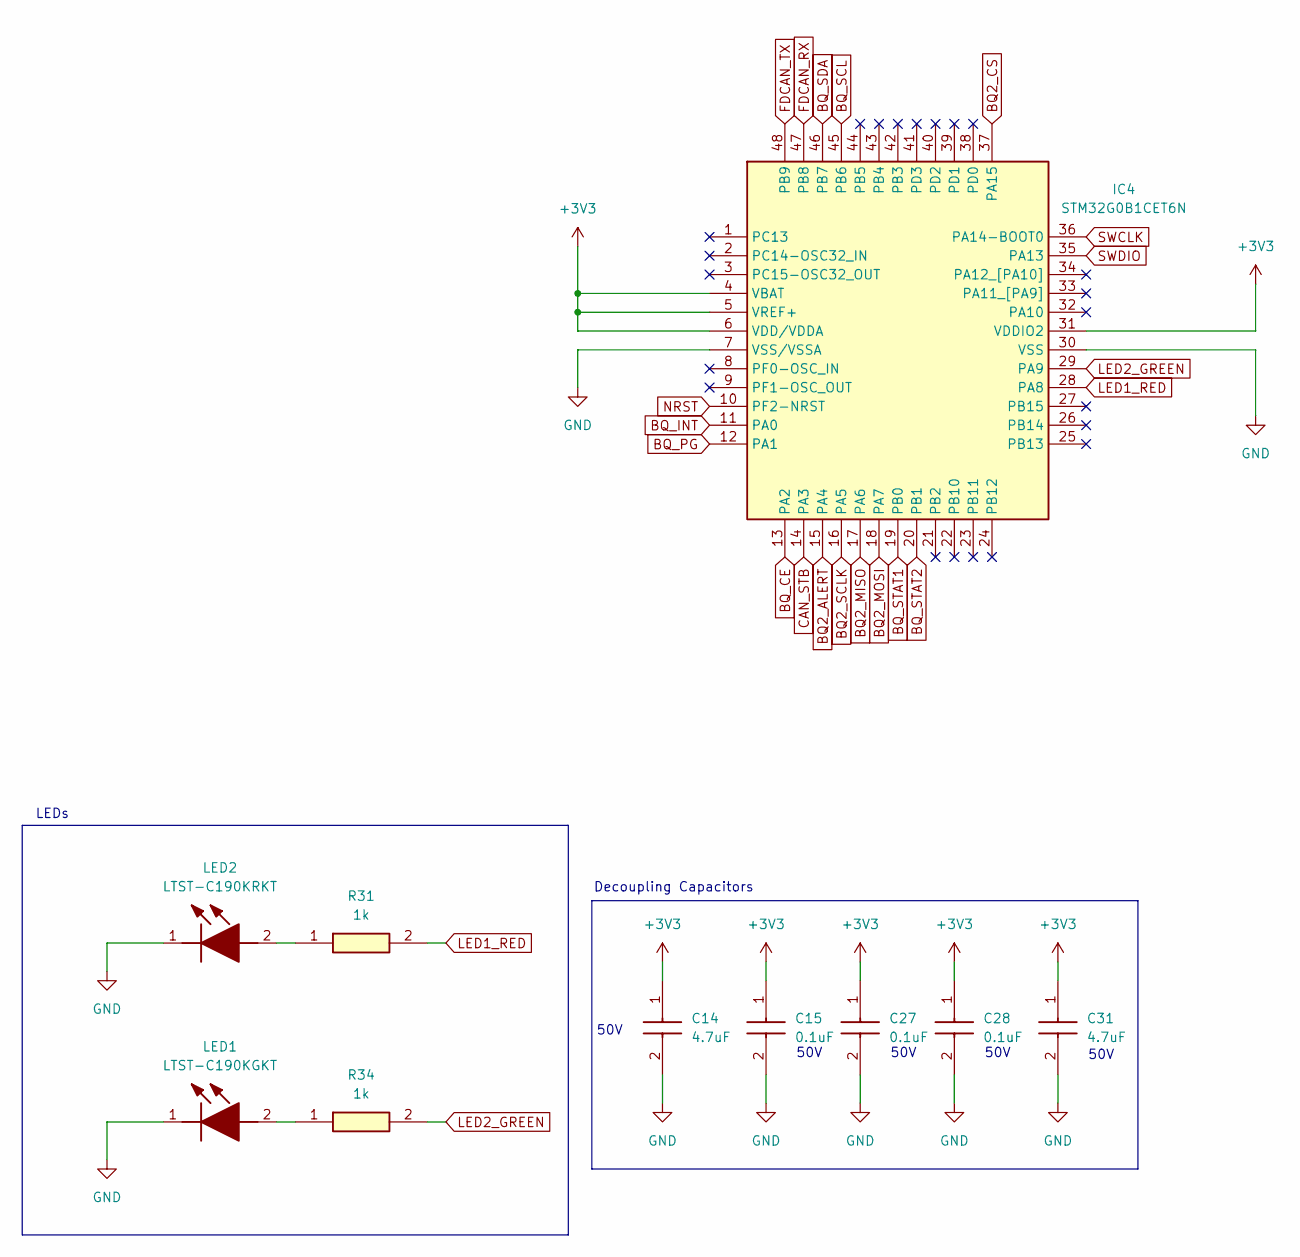
[picture p50: schematic mcu.kicad_sch]

Parts:
C14, C31: 4.7uF; CAPC3225X280N; Mouser Part Number 963-UMJ325AB7475KMHP
C15, C27, C28: 0.1uF; CAPC1608X90N; Mouser Part Number 603-CC603KRX7R9BB104
IC4: STM32G0B1CET6N; QFP50P900X900X160-48N; Mouser Part Number 511-STM32G0B1CET6N
LED1: LTST-C190KGKT; LEDC1608X80N; Mouser Part Number 859-LTST-C190KGKT
LED2: LTST-C190KRKT; LEDC1608X80N; Mouser Part Number 859-LTST-C190KRKT
R31, R34: 1k; RESC1608X55N; Mouser Part Number 603-RC0603FR-071KL

Connections:
+3V3: C14.1, C15.1, C27.1, C28.1, C31.1, IC4.4 (VBAT), IC4.5 (VREF+), IC4.6 (VDD/VDDA), IC4.31 (VDDIO2); also elsewhere on the board
BQ2_ALERT: IC4.15 (PA4); also elsewhere on the board
BQ2_CS: IC4.37 (PA15); also elsewhere on the board
BQ2_MISO: IC4.17 (PA6); also elsewhere on the board
BQ2_MOSI: IC4.18 (PA7); also elsewhere on the board
BQ2_SCLK: IC4.16 (PA5); also elsewhere on the board
BQ_CE: IC4.13 (PA2); also elsewhere on the board
BQ_INT: IC4.11 (PA0); also elsewhere on the board
BQ_PG: IC4.12 (PA1); also elsewhere on the board
BQ_SCL: IC4.45 (PB6); also elsewhere on the board
BQ_SDA: IC4.46 (PB7); also elsewhere on the board
BQ_STAT1: IC4.19 (PB0); also elsewhere on the board
BQ_STAT2: IC4.20 (PB1); also elsewhere on the board
CAN_STB: IC4.14 (PA3); also elsewhere on the board
FDCAN_RX: IC4.47 (PB8); also elsewhere on the board
FDCAN_TX: IC4.48 (PB9); also elsewhere on the board
GND: C14.2, C15.2, C27.2, C28.2, C31.2, IC4.7 (VSS/VSSA), IC4.30 (VSS), LED1.1 (K), LED2.1 (K); also elsewhere on the board
LED1_RED: IC4.28 (PA8), R31.2
LED2_GREEN: IC4.29 (PA9), R34.2
NRST: IC4.10 (PF2-NRST); also elsewhere on the board
unnamed: LED1.2 (A), R34.1
unnamed: LED2.2 (A), R31.1
SWCLK: IC4.36 (PA14-BOOT0); also elsewhere on the board
SWDIO: IC4.35 (PA13); also elsewhere on the board

Notes on the sheet:
Decoupling Capacitors
50V
LEDs

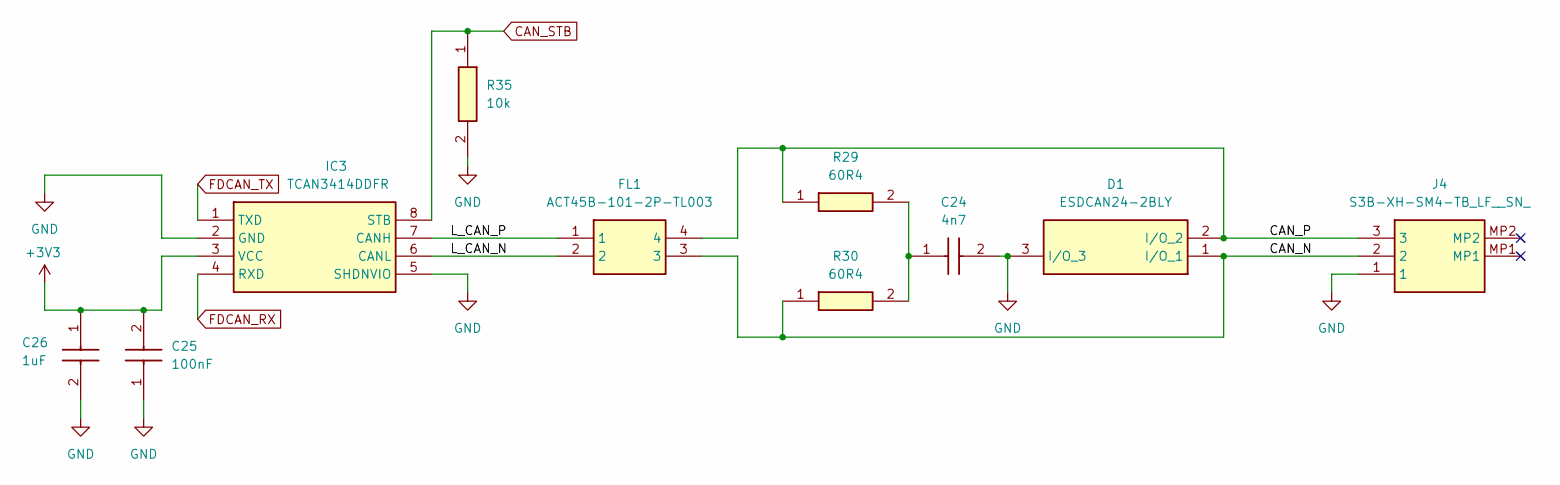
[picture p51: schematic CANBUS.kicad_sch]

Parts:
C24: 4n7; CAPC1608X90N; Mouser Part Number 81-GRM188R72A472KA1D
C25: 100nF; GRM15x; Mouser Part Number 81-GRM155R71H104KE4J
C26: 1uF; CAPC2012X145N; Mouser Part Number 810-C2012X7R1H105K
D1: ESDCAN24-2BLY; SOT95P255X125-3N; Mouser Part Number 511-ESDCAN24-2BLY
FL1: ACT45B-101-2P-TL003; ACT45B1012PTL003; Mouser Part Number 810-ACT45B1012PTL003
IC3: TCAN3414DDFR; INA190A2NDDFREP; Mouser Part Number 595-TCAN3414DDFR
J4: S3B-XH-SM4-TB_LF__SN_; S3BXHSM4TBLFSN; Mouser Part Number N/A
R29, R30: 60R4; ERJ2RKD1004X; Mouser Part Number 667-ERJ-2RKF60R4X
R35: 10k; RESC1608X55N; Mouser Part Number 603-RC0603FR-0710KL

Connections:
+3V3: C25.2, C26.1, IC3.3 (VCC); also elsewhere on the board
/CANBUS/CAN_N: D1.1 (I/O), FL1.3, J4.2, R30.1
/CANBUS/CAN_P: D1.2 (I/O), FL1.4, J4.3, R29.1
/CANBUS/L_CAN_N: FL1.2, IC3.6 (CANL)
/CANBUS/L_CAN_P: FL1.1, IC3.7 (CANH)
CAN_STB: IC3.8 (STB), R35.1; also elsewhere on the board
FDCAN_RX: IC3.4 (RXD); also elsewhere on the board
FDCAN_TX: IC3.1 (TXD); also elsewhere on the board
GND: C24.2, C25.1, C26.2, D1.3 (I/O), IC3.2 (GND), IC3.5 (SHDNVIO), J4.1, R35.2; also elsewhere on the board
unnamed: C24.1, R29.2, R30.2

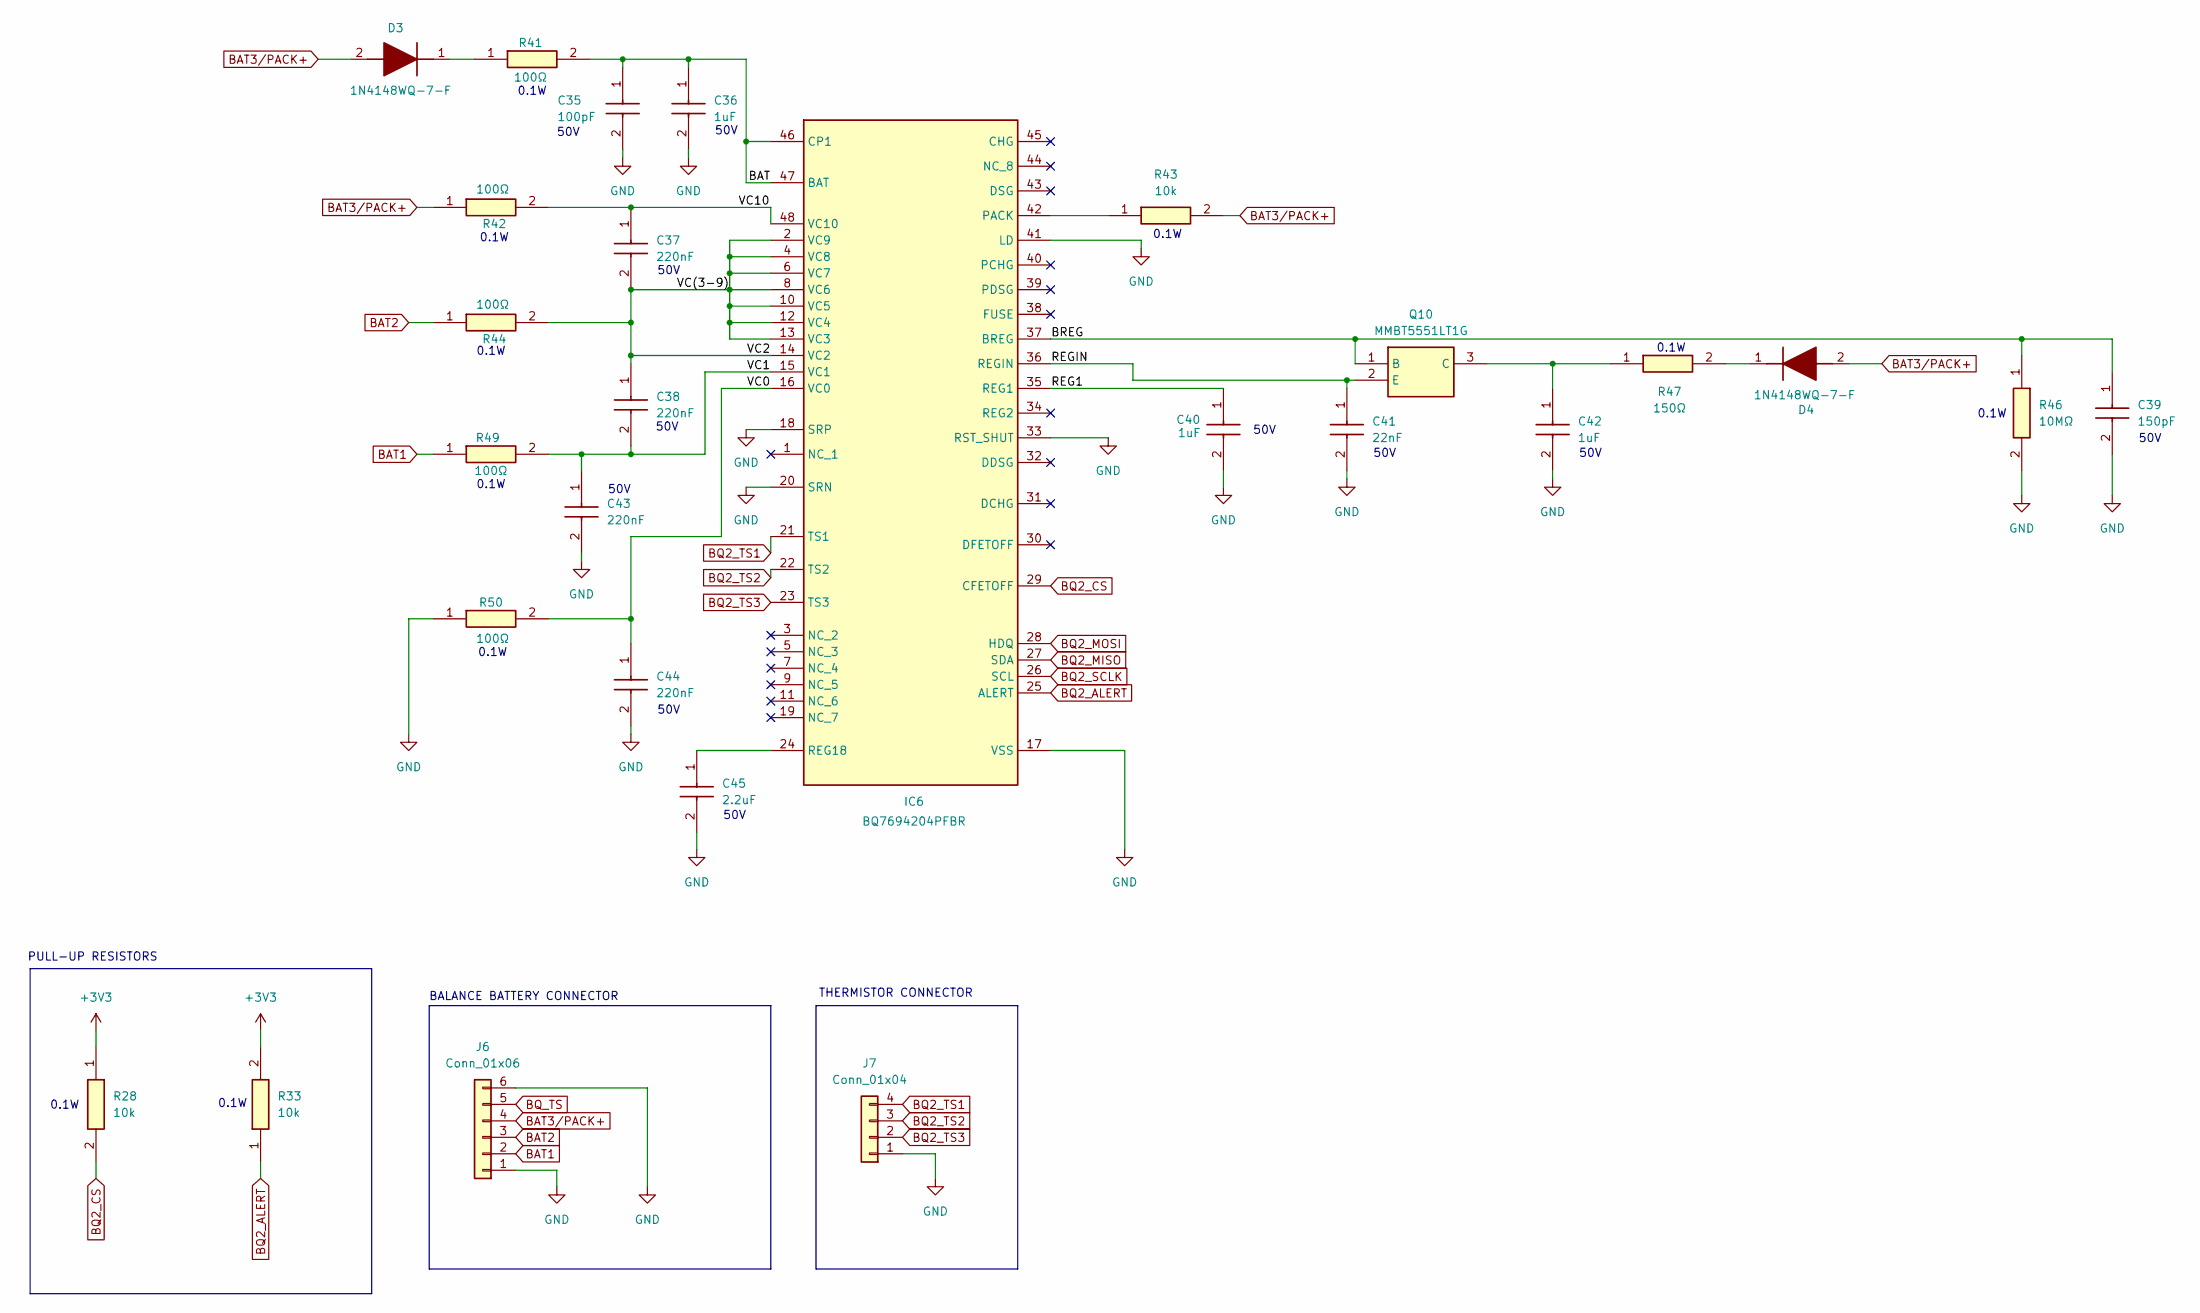
[picture p52: schematic Cell_Balancing.kicad_sch]

Parts:
C35: 100pF; CAPC1608X87N; Mouser Part Number 80-C0603C101J5G
C36, C40, C42: 1uF; CAPC2012X145N; Mouser Part Number 810-C2012X7R1H105K
C37, C38, C43, C44: 220nF; C0805; Mouser Part Number 80-C0805C224K5R
C39: 150pF; CAPC1608X87N; Mouser Part Number 80-C0603C151J5G
C41: 22nF; C0603; Mouser Part Number 80-C0603C223K5R
C45: 2.2uF; C1206; Mouser Part Number 80-C1206C225K5R
D3, D4: 1N4148WQ-7-F; SOD3716X145N; Mouser Part Number 621-1N4148WQ-7-F
IC6: BQ7694204PFBR; QFP50P900X900X120-48N; Mouser Part Number 595-BQ7694204PFBR
J6: Conn_01x06; JST_XH_B6B-XH-A_1x06_P2.50mm_Vertical
J7: Conn_01x04; JST_XH_B4B-XH-A_1x04_P2.50mm_Vertical
Q10: MMBT5551LT1G; SOT96P237X111-3N; Mouser Part Number 863-MMBT5551LT1G
R28, R33, R43: 10k; RESC1608X55N; Mouser Part Number 603-RC0603FR-0710KL
R41, R42, R44, R49, R50: 100Ω; RESC1608X55N; Mouser Part Number 603-RC0603FR-07100RL
R46: 10MΩ; RESC1608X55N; Mouser Part Number 603-RC0603FR-0710ML
R47: 150Ω; RESC1608X55N; Mouser Part Number 603-RC0603FR-07150RL

Connections:
+3V3: R28.1, R33.2; also elsewhere on the board
/CELL BALANCING IC/BAT: C35.1, C36.1, IC6.46 (CP1), IC6.47 (BAT), R41.2
/CELL BALANCING IC/BREG: C39.1, IC6.37 (BREG), Q10.1 (B), R46.1
/CELL BALANCING IC/REG1: C40.1, IC6.35 (REG1)
/CELL BALANCING IC/REGIN: C41.1, IC6.36 (REGIN), Q10.2 (E)
/CELL BALANCING IC/VC0: C44.1, IC6.16 (VC0), R50.2
/CELL BALANCING IC/VC1: C38.2, C43.1, IC6.15 (VC1), R49.2
/CELL BALANCING IC/VC10: C37.1, IC6.48 (VC10), R42.2
/CELL BALANCING IC/VC(3-9): C37.2, C38.1, IC6.2 (VC9), IC6.4 (VC8), IC6.6 (VC7), IC6.8 (VC6), IC6.10 (VC5), IC6.12 (VC4), IC6.13 (VC3), IC6.14 (VC2), R44.2
BAT1: J6.2, R49.1
BAT2: J6.3, R44.1
BAT3/PACK+: D3.2 (A), D4.2 (A), J6.4, R42.1, R43.2
BQ2_ALERT: IC6.25 (ALERT), R33.1; also elsewhere on the board
BQ2_CS: IC6.29 (CFETOFF), R28.2; also elsewhere on the board
BQ2_MISO: IC6.27 (SDA); also elsewhere on the board
BQ2_MOSI: IC6.28 (HDQ); also elsewhere on the board
BQ2_SCLK: IC6.26 (SCL); also elsewhere on the board
BQ2_TS1: IC6.21 (TS1), J7.4
BQ2_TS2: IC6.22 (TS2), J7.3
BQ2_TS3: IC6.23 (TS3), J7.2
BQ_TS: J6.5; also elsewhere on the board
GND: C35.2, C36.2, C39.2, C40.2, C41.2, C42.2, C43.2, C44.2, C45.2, IC6.17 (VSS), IC6.18 (SRP), IC6.20 (SRN), IC6.33 (RST_SHUT), IC6.41 (LD), J6.1, J6.6, J7.1, R46.2, R50.1; also elsewhere on the board
unnamed: D3.1 (K), R41.1
unnamed: D4.1 (K), R47.2
unnamed: IC6.42 (PACK), R43.1
unnamed: C45.1, IC6.24 (REG18)
unnamed: C42.1, Q10.3 (C), R47.1

Notes on the sheet:
50V
0.1W
PULL-UP RESISTORS
BALANCE BATTERY CONNECTOR
THERMISTOR CONNECTOR

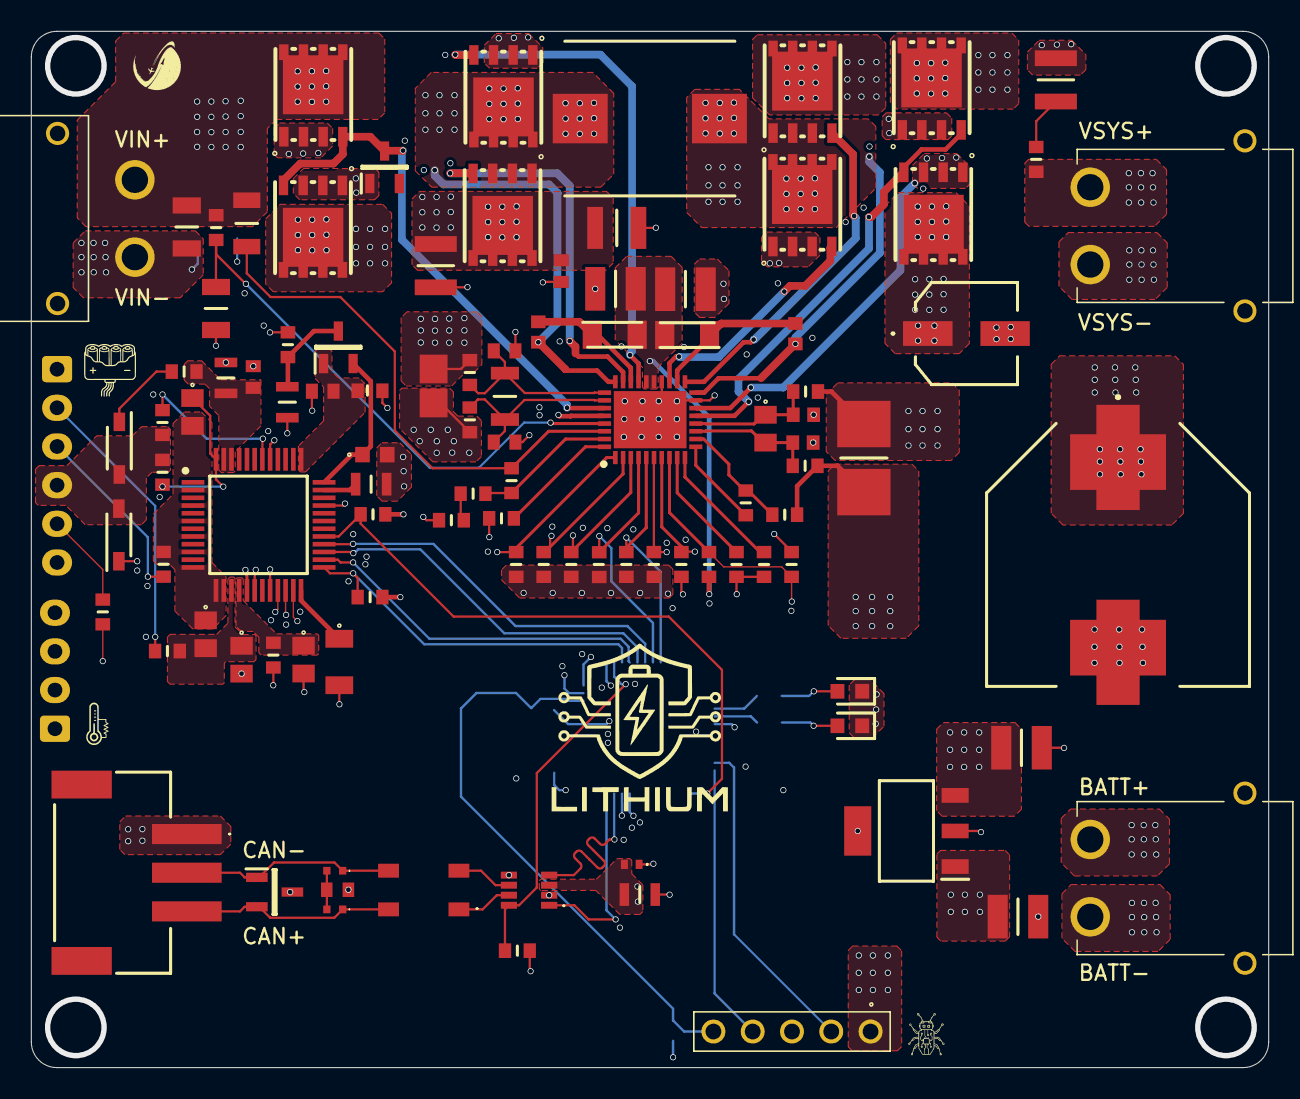
[picture p53: board Lithium_Board.kicad_pcb from above]

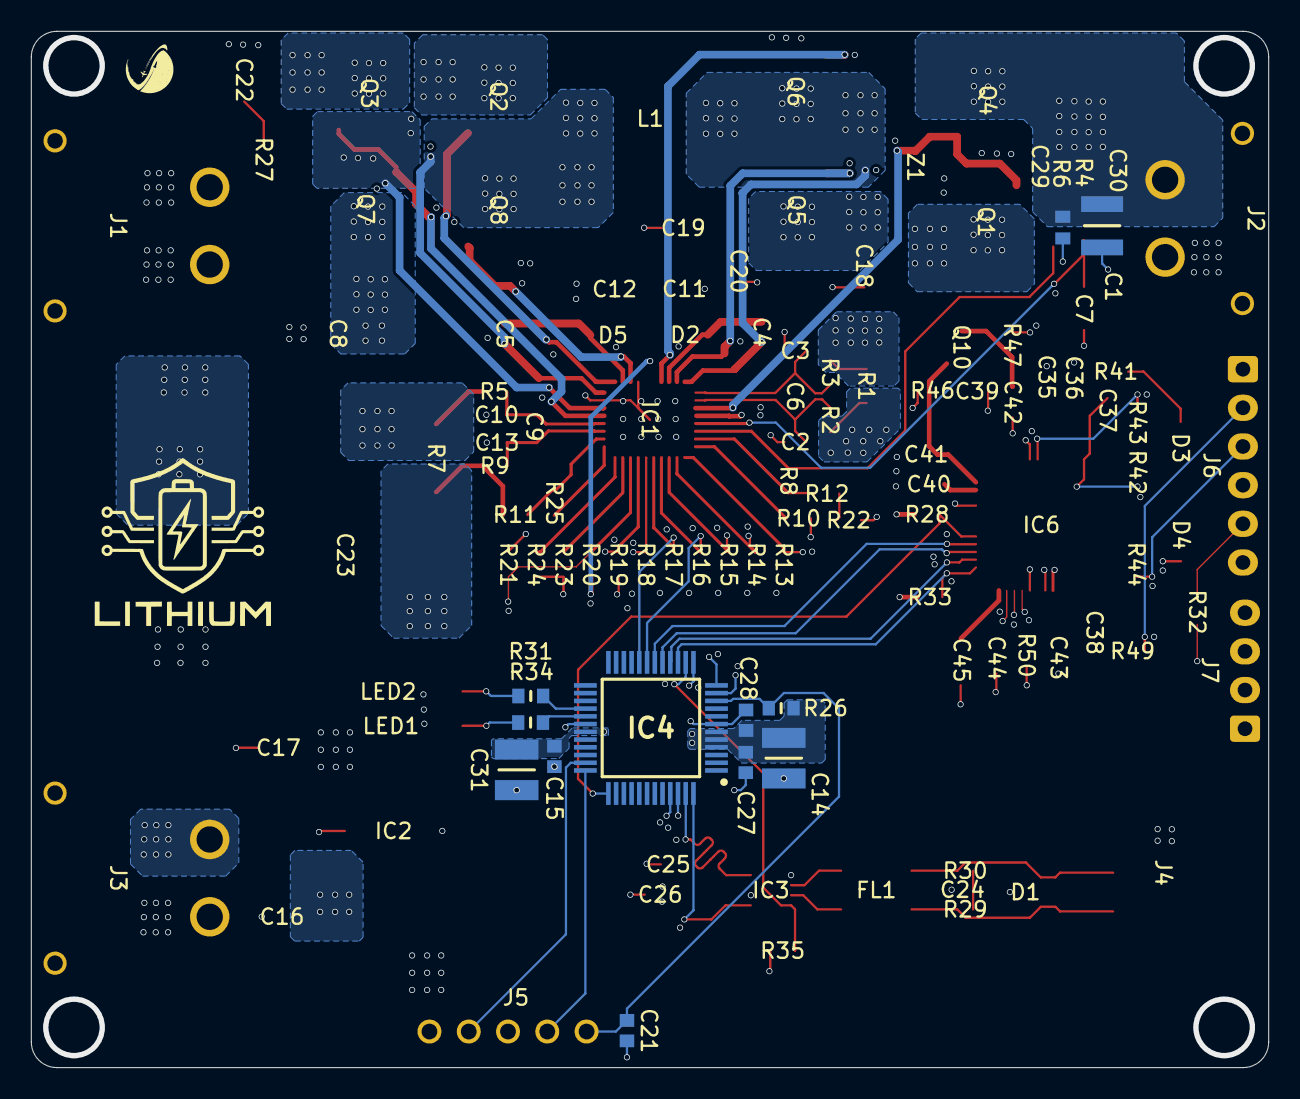
[picture p54: board Lithium_Board.kicad_pcb from below]

Board: 6 copper layers, 80.0 x 67.0 mm, 116 parts (12 on the bottom side), 81 nets.
