tommy2002t/LITHIUM_BOARD/(commit log)

2026-05-31 Added CELL BALANCING IC
    [C0603C101J5GACTU.SchLib, C0603C101J5GACTU.stp, CAPC1608X87N.PcbLib, EDI2CAP.CFG, Lithium_Board.kicad_sch, RC0603FR-0710ML.SchLib, RC0603FR-0710ML.stp, RC0603FR-07150RL.SchLib]
2026-05-31 Added Hierarchical Sheets
    [Cell_Balancing.kicad_sch, Lithium_Board.kicad_sch, mcu.kicad_sch]
2026-05-31 First Layout Try
    [Lithium_Board.kicad_pcb]
2026-06-01 Added Ratings+Net Labels+First Layout Try+Calculations Excel
    [Cell_Balancing.kicad_sch, LITHIUM_Board_Design_Calculations.xlsx, Lithium_Board.kicad_pcb, Lithium_Board.kicad_sch]
2026-06-03 New Cleaner Layout + Cell Balancing Connector
    [Lithium_Board.kicad_pcb, Lithium_Board.kicad_sch]
2026-06-06 Added Canbus+LEDs+New STM32
    [ACT45B-101-2P-TL003.SchLib, ACT45B-101-2P-TL003.stp, ACT45B1012PTL003.PcbLib, CANBUS.kicad_sch, CAPC1608X90N.PcbLib, CDSOT23-T24CAN.SchLib, CDSOT23-T24CAN.stp, EDI2CAP.CFG]
2026-06-06 Added Single-Cell Thermistor Pins
    [Cell_Balancing.kicad_sch, Lithium_Board.kicad_pcb]
2026-06-07 Added New Potential Layout
    [Lithium_Board.kicad_pcb]
2026-06-09 Wrong Side Longer Layout
    [Lithium_Board.kicad_pcb]
2026-06-09 First Actual Design (No Return Vias, no Logo)
    [Lithium_Board.kicad_pcb]
2026-06-10 First Layout Completed
    [Lithium_Board.kicad_pcb]
2026-06-14 First Changes
    [CDBMT2100-HF.SchLib, CDBMT2100-HF.stp, Cell_Balancing.kicad_sch, EDI2CAP.CFG, Lithium_Board.kicad_pcb, Lithium_Board.kicad_sch, Lithium_Board.step, SODFL3516X100N.PcbLib]
2026-06-20 3D MODELS ADDED
    [Lithium_Board.kicad_pcb]
2026-06-20 NEW 3D MODELS
    [Lithium_Board.kicad_pcb, Lithium_Board.step]
2026-06-20 Final PERFECT design before big changes
    [Lithium_Board.kicad_pcb, Lithium_Board.kicad_sch]
2026-06-22 New Placement and Polygons
    [Lithium_Board.kicad_pcb, mcu.kicad_sch]
2026-06-22 LITHIUM V2 Placement
    [Lithium_Board.kicad_pcb]
2026-06-22 Final LITHIUM Design V2
    [Lithium_Board.kicad_pcb]
2026-06-23 Differential Routing
    [Lithium_Board.kicad_pcb]
2026-06-24 CANBUS FIXED
    [Lithium_Board.kicad_pcb]
2026-06-24 Perfected Polygons
    [Lithium_Board.kicad_pcb]
2026-06-25 Added Return Vias
    [Lithium_Board.kicad_pcb]
2026-06-26 Small Changes
    [Lithium_Board.kicad_pcb, Lithium_Board.kicad_sch]
2026-06-28 TS fixed + Small Changes
    [Cell_Balancing.kicad_sch, Lithium_Board.kicad_pcb, Lithium_Board.kicad_sch]
2026-06-28 Fixed Step File
    [Lithium_Board.kicad_pcb, Lithium_Board.step]
2026-06-30 Mini Review Changes
    [Lithium_Board.kicad_pcb]
2026-07-01 Mini Review #2
    [Lithium_Board.kicad_pcb]
2026-07-01 Mini Review #2.1
    [Lithium_Board.kicad_pcb]
2026-07-05 All 3D-Models Fixed
    [Lithium_Board.kicad_pcb, POWERPAK_SO-8_SINGLE_VIS.step]
2026-07-07 Via Arrays Fixed
    [Lithium_Board.kicad_pcb]
2026-07-07 Added BOM
    [Lithium_Board.csv]
2026-07-07 Fixed BOM
    [Lithium_Board.csv]
2026-07-12 Review Changes #2
    [Lithium_Board.kicad_pcb]
2026-07-14 Vias in Pad Fixed
    [Lithium_Board.kicad_pcb]
2026-07-15 First Big Review Changes
    [EDI2CAP.CFG, Lithium_Board.kicad_pcb, Lithium_Board.kicad_sch, RESC1608X55N.PcbLib, RT0603BRD07249KL.SchLib, RT0603BRD07249KL.stp, RT0603BRD0735K2L.SchLib, RT0603BRD0735K2L.stp]
2026-07-15 Fixed Big Capacitor
    [EDI2CAP.CFG, EEE-TP1K391V.stp, Lithium_Board.kicad_pcb, Lithium_Board.kicad_sch, chips.prt]
2026-07-16 Final Changes+Stackup Fixed
    [EDI2CAP.CFG, EEH-ZL1E151P.stp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]
2026-07-18 Polygons Fixed
    [Lithium_Board.kicad_pcb]
2026-07-19 Fixed 3D Models
    [Lithium_Board.kicad_pcb]
2026-07-19 New Gerbers and BOM
    [Lithium_Board-B_Cu.gbr, Lithium_Board-B_Mask.gbr, Lithium_Board-B_Paste.gbr, Lithium_Board-B_Silkscreen.gbr, Lithium_Board-Edge_Cuts.gbr, Lithium_Board-F_Cu.gbr, Lithium_Board-F_Mask.gbr, Lithium_Board-F_Paste.gbr]
2026-07-22 Fixed Mounting Holes
    [Lithium_Board.kicad_pcb]
2026-07-23 Fixed Items Not in Stock
    [CANBUS.kicad_sch, EDI2CAP.CFG, ESDCAN24-2BLY.SchLib, ESDCAN24-2BLY.stp, Lithium_Board.kicad_pcb, Lithium_Board.kicad_sch, QFP50P900X900X160-48N.PcbLib, SOT95P255X125-3N.PcbLib]
2026-07-23 New BOM+GRB
    [CANBUS.kicad_sch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]
2026-07-23 BOM Fixed+CS Fixed
    [Lithium_Board.csv, Lithium_Board.kicad_pcb, mcu.kicad_sch]
2026-07-23 NRST+Polygon Fixed
    [Lithium_Board.kicad_pcb]
2026-07-23 Cap to GND fixed
    [Cell_Balancing.kicad_sch, Lithium_Board.kicad_pcb]
2026-07-23 Final Gerber Files
    [Lithium_Board-B_Cu.gbr, Lithium_Board-B_Mask.gbr, Lithium_Board-B_Paste.gbr, Lithium_Board-B_Silkscreen.gbr, Lithium_Board-Edge_Cuts.gbr, Lithium_Board-F_Cu.gbr, Lithium_Board-F_Mask.gbr, Lithium_Board-F_Paste.gbr]
2026-07-24 Stackup+LEDs+Silkscreen Fixes
    [Lithium_Board-B_Cu.gbr, Lithium_Board-B_Mask.gbr, Lithium_Board-B_Paste.gbr, Lithium_Board-B_Silkscreen.gbr, Lithium_Board-Edge_Cuts.gbr, Lithium_Board-F_Cu.gbr, Lithium_Board-F_Mask.gbr, Lithium_Board-F_Paste.gbr]
